RobotBuzzard/KegWasher/KegConfig.h

#define KEG_CONFIG_H
#include <Arduino.h>
#include <SPI.h>
#include <SD.h>
extern bool kwBenchMode;
#define airOk                  DI6
#define co2Ok                  DI7
#define ESTOP                  DI8
#define causticTemp            A10
#define waterOk                A11
#define causticLevelSensor     A12
#define largeKeg               IO0
#define cycleStart             IO1
#define manualDrain            IO2
#define co2Out                 IO3
#define alarmOut               IO4    // RED fault / E-stop stacklight (HIGH = on)
#define readyLedOut            IO5    // GREEN cycle-start / ready indicator (HIGH = on)
#define drainOut               CLEARCORE_PIN_CCIOA0
#define waterOut               CLEARCORE_PIN_CCIOA1
#define airOut                 CLEARCORE_PIN_CCIOA2
#define causticOut             CLEARCORE_PIN_CCIOA3
#define pumpOut                CLEARCORE_PIN_CCIOA4
#define sanitizerOut           CLEARCORE_PIN_CCIOA5
#define causticHeaterOut       CLEARCORE_PIN_CCIOA6
#define kegsDoneOut            CLEARCORE_PIN_CCIOA7  // HIGH while COMPLETE (swap-kegs
#define CcioPort               ConnectorCOM0
#define displayPort            ConnectorCOM1
#define settingsFileName       "WASHER.CFG"
#define KEY_MAX_LENGTH         30
#define VALUE_MAX_LENGTH       30
#define MACH_IDLE        0   // ready / not-ready; waiting for Start (see idleSub)
#define MACH_STARTING    1   // warm-up: heating caustic to temp before Execute
#define MACH_EXECUTE     2   // running the recipe (recipePhase advances within)
#define MACH_HELD        3   // paused mid-recipe; outputs safely held, timer frozen
#define MACH_COMPLETE    4   // cycle done; alarm; Start=next keg / Reset=park
#define MACH_STOPPING    5   // operator STOP/DRAIN: evacuating keg contents
#define MACH_STOPPED     6   // de-energized halt; Reset (Start) recovers
#define MACH_CLEARING    7   // fault acknowledged, verifying cleared → Stopped
#define MACH_ABORTED     8   // fault/ESTOP landing; alarm; Clear begins recovery
#define NUM_MACH_STATES  9
#define PHASE_NONE             0
#define PHASE_DIRTY_DRAIN      1   // air-push old product out (air + drain)   → drain
#define PHASE_DIRTY_RINSE      2   // pre-rinse water + drain                  → drain
#define PHASE_DIRTY_PURGE      3   // air-blow pre-rinse water + drain         → drain
#define PHASE_WASHING          4   // recirculate hot caustic (caustic + pump)
#define PHASE_CAUSTIC_RETURN   5   // air-blow caustic, drain+pump OFF         → caustic reservoir
#define PHASE_RINSING          6   // post-caustic rinse water + drain         → drain
#define PHASE_RINSE_PURGE      7   // air-blow rinse water + drain             → drain
#define PHASE_SANITIZE         8   // recirculate sanitizer (sanitizer + pump)
#define PHASE_SANI_RETURN      9   // CO2-blow sanitizer, drain+pump OFF       → sani reservoir
#define PHASE_PRESSURE         10  // CO2 charge, valves closed (seal keg)
#define NUM_PHASES             11
#define PHASE_FIRST            PHASE_DIRTY_DRAIN
#define PHASE_LAST             PHASE_PRESSURE
#define IDLE_INIT              0   // one-shot init ceremony on entering IDLE
#define IDLE_NOT_READY         1   // systems offline; shows which are failing
#define IDLE_READY             2   // ready; START begins a cycle
#define IDLE_SETTINGS          3   // on-screen settings editor (Phase 5 — not yet wired)
#define KW_FIRMWARE_VERSION    "1.0.2"
#define adcResolution          12
#define ADC_MAX                4095
#define DEF_ETS_SHUNT_OHMS     470.0f
extern float etsShuntOhms;
#define DEF_LARGE_KEG_MOD      1.5
#define DEFAULT_MIN_CAUSTIC_TEMP       50   // below this in WASHING → fault
#define DEFAULT_OPTIMAL_CAUSTIC_TEMP   60   // heater target during STARTING
#define DEFAULT_MAX_CAUSTIC_TEMP       70   // caustic safety cutoff
#define DEF_MIN_HEATING_RATE   3         // °C/min minimum during fw-mode heating
#define DEF_MAX_HEATING_MS     900000UL  // 15 min heating cap
extern int           minHeatingRate;     // SD key: minHeatingRate (°C/min)
extern unsigned long maxHeatingMs;       // SD key: maxHeatingMs (STARTING bound, both modes)
extern bool heaterExternal;
#define ERR_NONE              0
#define ERR_SD_INIT           1
#define ERR_CONFIG_FILE       2
#define ERR_WATER_PRESSURE    3
#define ERR_AIR_PRESSURE      4
#define ERR_CO2_PRESSURE      5
#define ERR_CAUSTIC_TEMP      6
#define ERR_ESTOP             8
#define ERR_INVALID_STATE     9
#define ERR_HEATING_TIMEOUT   10
#define ERR_HEATING_RATE      11
#define ERR_CAUSTIC_LEVEL     12
#define ERR_HEATER_OVERTEMP   13
#define ERR_STATE_TIMEOUT     14
#define ERR_SENSOR_FAULT      15
#define ERR_PAUSE_TIMEOUT     16
#define PAUSE_MAX_MS          (10UL * 60 * 1000)
extern unsigned long dirtyDrainTimer;   // DIRTY_DRAIN
extern unsigned long dirtyRinseTimer;   // DIRTY_RINSE
extern unsigned long dirtyPurgeTimer;   // DIRTY_PURGE
extern unsigned long washTimer;         // WASHING
extern unsigned long causticRtnTimer;   // CAUSTIC_RETURN (air-blow caustic → reservoir)
extern unsigned long rinseTimer;        // RINSING
extern unsigned long rinsePurgeTimer;   // RINSE_PURGE (air-blow rinse water → drain)
extern unsigned long saniTimer;         // SANITIZE
extern unsigned long saniRtnTimer;      // SANI_RETURN (CO2-blow sanitizer → reservoir)
extern unsigned long purgeTimer;        // PRESSURE (CO2 charge / seal)
extern unsigned long fullDrainTimer;
extern double largeKegMod;
extern unsigned long pauseMaxMs;
extern float  cfgTouchCal[6];    // touch calibration affine coeffs (a,b,c,d,e,f)
extern bool   cfgTouchCalValid;  // true once SD config supplied touchCalA..F
extern bool   cfgLoadedFromSD;   // true if WASHER.CFG was read; false = compiled defaults
extern int minCausticTemp;       // WASHING abort floor
extern int optimalCausticTemp;   // STARTING heater target
extern int tempCalOffsetC10;     // caustic probe calibration offset, tenths of a degree C (panel-tunable)
extern int maxCausticTemp;       // caustic safety cutoff
extern char mqttBrokerIp[16];    // dotted-quad string, e.g. "192.168.1.111"
extern int  mqttBrokerPort;
extern char mqttUser[32];
extern char mqttPass[32];
extern char mqttClientId[32];
extern char mqttTopicRoot[32];
extern char webUser[24];
extern char webPass[24];
extern bool netStaticMode;
extern char netIp[16];
extern char netMask[16];
extern char netGw[16];
bool config_parseIp(const char* s, uint8_t out[4]);
extern bool kwCfgMirrorDirty;
void config_init();
bool config_loadFromSD();
void config_saveToSD();
void config_setDefaults();
#define KW_CFG_APPLIED   0
#define KW_CFG_UNKNOWN   1
#define KW_CFG_REJECTED  2
byte config_applyKV(const char* key, const char* value);
bool config_tempsOrdered();   // floor ≤ target < cutoff
