RobotBuzzard/KegWasher/KegConfig.cpp

// ======================================================================
// KegConfig.cpp - SD config load/save with bounded validation
// ======================================================================
#include "KegConfig.h"
#include "KegUtils.h"
#include "KegDisplay.h"
#include "KegDiagnostics.h"
#include "KegSecrets.h"   // compiled MQTT broker/cred defaults (seed the runtime globals)

// Stringize the 4 broker-IP octet macros into a "a.b.c.d" literal for the
// compile-time default of mqttBrokerIp (static init can't run snprintf).
#define KW_STR2(x) #x
#define KW_STR(x)  KW_STR2(x)

// Per-stage default durations (ms). The washer is a TWO-HEAD system — one cycle
// cleans 2 kegs in parallel — so these are per-cycle (both kegs), not per keg.
// Production defaults total ≈ 4.4 min/cycle; tune per process via WASHER.CFG or
// the on-screen settings editor. BENCH_MODE compresses every stage to 5 s so a
// cardless bench cycle runs in ~50 s. (5 s multiples → clean ±5 s editor steps.)
  #define DEF_DIRTY_DRAIN_MS  20000UL   // drain old beer (air on whole stage)
  #define DEF_DIRTY_RINSE_MS  20000UL   // pre-rinse
  #define DEF_DIRTY_PURGE_MS  10000UL   // air blow to drain
  #define DEF_WASH_MS         90000UL   // caustic recirc — the real clean
  #define DEF_CAUSTIC_RTN_MS  15000UL   // air-blow caustic back to tank
  #define DEF_RINSE_MS        25000UL   // post-caustic rinse
  #define DEF_RINSE_PURGE_MS  10000UL   // air blow to drain
  #define DEF_SANI_MS         45000UL   // sanitizer recirc
  #define DEF_SANI_RTN_MS     15000UL   // CO2-blow sani back to tank
  #define DEF_PRESSURE_MS     15000UL   // CO2 charge / seal
  #define DEF_FULL_DRAIN_MS   180000UL  // DIRTY_DRAIN w/ DRAIN switch latched (full kegs)

// Stage durations, in cycle order. See KegConfig.h for the stage each drives.
unsigned long dirtyDrainTimer = DEF_DIRTY_DRAIN_MS;
unsigned long dirtyRinseTimer = DEF_DIRTY_RINSE_MS;
unsigned long dirtyPurgeTimer = DEF_DIRTY_PURGE_MS;
unsigned long washTimer       = DEF_WASH_MS;
unsigned long causticRtnTimer = DEF_CAUSTIC_RTN_MS;
unsigned long rinseTimer      = DEF_RINSE_MS;
unsigned long rinsePurgeTimer = DEF_RINSE_PURGE_MS;
unsigned long saniTimer       = DEF_SANI_MS;
unsigned long saniRtnTimer    = DEF_SANI_RTN_MS;
unsigned long purgeTimer      = DEF_PRESSURE_MS;
unsigned long fullDrainTimer  = DEF_FULL_DRAIN_MS;
double        largeKegMod     = DEF_LARGE_KEG_MOD;
unsigned long pauseMaxMs      = PAUSE_MAX_MS;   // runtime; SD-overridable (Phase 3)

// Temperature thresholds (°C) — seeded from DEFAULT_*; SD-overridable.
int minCausticTemp     = DEFAULT_MIN_CAUSTIC_TEMP;
int optimalCausticTemp = DEFAULT_OPTIMAL_CAUSTIC_TEMP;
int maxCausticTemp     = DEFAULT_MAX_CAUSTIC_TEMP;
int tempCalOffsetC10   = 0;   // calibration trim vs a reference thermometer

// Heating bounds + temp-sensor shunt — SD-overridable (were compile-time).
int           minHeatingRate = DEF_MIN_HEATING_RATE;
unsigned long maxHeatingMs   = DEF_MAX_HEATING_MS;
float         etsShuntOhms   = DEF_ETS_SHUNT_OHMS;

// Heater control mode — see KegConfig.h. Default fw (safe on direct wiring).
bool heaterExternal = false;

// Runtime bench mode — set in config_init(): no SD config -> bench (gates
// bypassed + 5 s stages); card present -> production gates, unless the card
// (or a remote edit) says benchMode=on. See KegConfig.h.
bool kwBenchMode = false;
// benchMode SD key state: seen-in-file + its value. Needed because the loader
// runs BEFORE config_init() decides the card-present default — config_init
// consults these instead of the (would-be-clobbered) kwBenchMode itself.
static bool cfgBenchKeySeen = false;
static bool cfgBenchKeyVal  = false;

// Network config — applied at BOOT by setupEthernet(); a remote edit needs a
// power cycle to take effect. netMode=static requires a valid netIp (else the
// boot logs a fallback and uses DHCP). netMask defaults to 255.255.255.0 and
// netGw to .1 on the IP's subnet when unset.
bool netStaticMode = false;
char netIp[16]   = "";
char netMask[16] = "";
char netGw[16]   = "";

// Dotted-quad parser shared by validation and setupEthernet.
bool config_parseIp(const char* s, uint8_t out[4]) {
  int v[4];
  char extra;
  if (sscanf(s, "%d.%d.%d.%d%c", &v[0], &v[1], &v[2], &v[3], &extra) != 4) {
    return false;
  }
  for (int i = 0; i < 4; i++) {
    if (v[i] < 0 || v[i] > 255) return false;
    out[i] = (uint8_t)v[i];
  }
  return true;
}

// Web editor HTTP Basic auth — both must be non-empty to arm it. Never
// published to the cfg/* mirror or cfg.json; settable remotely (masked in
// acks/logs) so the lock can be enabled from the editor itself. Recovery
// from a lost password: pull the card and edit/delete the webUser/webPass
// lines in WASHER.CFG.
char webUser[24] = "";
char webPass[24] = "";

// MQTT broker config — seeded from KegSecrets.h; SD-overridable per device.
char mqttBrokerIp[16]  = KW_STR(MQTT_BROKER_IP_0) "." KW_STR(MQTT_BROKER_IP_1) "."
                         KW_STR(MQTT_BROKER_IP_2) "." KW_STR(MQTT_BROKER_IP_3);
int  mqttBrokerPort    = MQTT_BROKER_PORT;
char mqttUser[32]      = MQTT_USER;
char mqttPass[32]      = MQTT_PASS;
char mqttClientId[32]  = MQTT_CLIENT_ID;
char mqttTopicRoot[32] = MQTT_TOPIC_ROOT;

// Touch calibration (host-side affine: screen=[a b c; d e f].[rawx rawy 1]).
// KegDisplaySerial has its own baked defaults; these only override when the SD
// config supplies touchCalA..F (which sets cfgTouchCalValid → display_init applies).
float cfgTouchCal[6]  = {1, 0, 0, 0, 1, 0};
bool  cfgTouchCalValid = false;
bool  cfgLoadedFromSD  = false;   // set by config_init(); drives the boot-screen SD line

// Set by every config_saveToSD(); the main loop republishes the MQTT cfg/*
// mirror and clears it. Closes the two-editor desync: the PANEL settings
// editor saves without touching MQTT, which left the mirror (and anything
// watching it) showing stale values — bitten 2026-07-05 when MIN TEMP was
// changed on-panel while the mirror still said the web-set value.
bool kwCfgMirrorDirty = false;

static File settingsFile;

// Accept timer values from 5s to 30min. The 5s floor allows the genuinely short
// purge/return/charge stages (air blow-down, CO2 charge) while still rejecting
// obvious typos (e.g. a forgotten trailing zero / a 0-length stage).
static const unsigned long TIMER_MIN_MS = 5000UL;
static const unsigned long TIMER_MAX_MS = 1800000UL;
static const double KEGMOD_MIN = 1.0;
static const double KEGMOD_MAX = 3.0;
static const int  TEMP_MIN_C   = 0;        // plausible threshold range (°C)
static const int  TEMP_MAX_C   = 120;
static const unsigned long PAUSE_MIN_MS   = 60000UL;       // 1 min
static const unsigned long PAUSE_LIMIT_MS = 3600000UL;     // 60 min

static void logOutOfRange(const char* key, const char* value) {
  diagnostics_logEvent((String("Config out of range: ") + key + "=" + value).c_str());
}

static bool applyTimerKey(const char* key, const char* value, unsigned long& target) {
  unsigned long v = strtoul(value, nullptr, 10);
  if (v < TIMER_MIN_MS || v > TIMER_MAX_MS) { logOutOfRange(key, value); return false; }
  target = v;
  return true;
}

// Bounded integer (temperature thresholds).
static bool applyTempKey(const char* key, const char* value, int& target) {
  int v = atoi(value);
  if (v < TEMP_MIN_C || v > TEMP_MAX_C) { logOutOfRange(key, value); return false; }
  target = v;
  return true;
}

// Free-form string value → fixed buffer (snprintf null-terminates + truncates).
static void applyStrKey(const char* value, char* target, size_t cap) {
  snprintf(target, cap, "%s", value);
}

// Apply one KEY=VALUE pair with bounded validation — the single rulebook shared
// by the SD loader and the remote (MQTT cfgset) editor. Returns:
//   KW_CFG_APPLIED   value accepted (target updated)
//   KW_CFG_UNKNOWN   key not recognised (loader ignores; remote editor errors)
//   KW_CFG_REJECTED  value out of range (logged; target unchanged)
byte config_applyKV(const char* key, const char* value) {
  if      (strcmp(key, "fullDrainTimer") == 0)  return applyTimerKey(key, value, fullDrainTimer)  ? KW_CFG_APPLIED : KW_CFG_REJECTED;
  else if (strcmp(key, "dirtyDrainTimer") == 0) return applyTimerKey(key, value, dirtyDrainTimer) ? KW_CFG_APPLIED : KW_CFG_REJECTED;
  else if (strcmp(key, "dirtyRinseTimer") == 0) return applyTimerKey(key, value, dirtyRinseTimer) ? KW_CFG_APPLIED : KW_CFG_REJECTED;
  else if (strcmp(key, "dirtyPurgeTimer") == 0) return applyTimerKey(key, value, dirtyPurgeTimer) ? KW_CFG_APPLIED : KW_CFG_REJECTED;
  else if (strcmp(key, "washTimer")       == 0) return applyTimerKey(key, value, washTimer)       ? KW_CFG_APPLIED : KW_CFG_REJECTED;
  else if (strcmp(key, "causticRtnTimer") == 0) return applyTimerKey(key, value, causticRtnTimer) ? KW_CFG_APPLIED : KW_CFG_REJECTED;
  else if (strcmp(key, "rinseTimer")      == 0) return applyTimerKey(key, value, rinseTimer)      ? KW_CFG_APPLIED : KW_CFG_REJECTED;
  else if (strcmp(key, "rinsePurgeTimer") == 0) return applyTimerKey(key, value, rinsePurgeTimer) ? KW_CFG_APPLIED : KW_CFG_REJECTED;
  else if (strcmp(key, "saniTimer")       == 0) return applyTimerKey(key, value, saniTimer)       ? KW_CFG_APPLIED : KW_CFG_REJECTED;
  else if (strcmp(key, "saniRtnTimer")    == 0) return applyTimerKey(key, value, saniRtnTimer)    ? KW_CFG_APPLIED : KW_CFG_REJECTED;
  else if (strcmp(key, "purgeTimer")      == 0) return applyTimerKey(key, value, purgeTimer)      ? KW_CFG_APPLIED : KW_CFG_REJECTED;
  else if (strcmp(key, "largeKegMod")     == 0) {
    double v = atof(value);
    if (v < KEGMOD_MIN || v > KEGMOD_MAX) { logOutOfRange(key, value); return KW_CFG_REJECTED; }
    largeKegMod = v;
    return KW_CFG_APPLIED;
  }
  else if (strcmp(key, "pauseMaxMs")      == 0) {
    unsigned long v = strtoul(value, nullptr, 10);
    if (v < PAUSE_MIN_MS || v > PAUSE_LIMIT_MS) { logOutOfRange(key, value); return KW_CFG_REJECTED; }
    pauseMaxMs = v;
    return KW_CFG_APPLIED;
  }
  // Temperature thresholds (°C)
  else if (strcmp(key, "minCausticTemp")     == 0) return applyTempKey(key, value, minCausticTemp)     ? KW_CFG_APPLIED : KW_CFG_REJECTED;
  else if (strcmp(key, "optimalCausticTemp") == 0) return applyTempKey(key, value, optimalCausticTemp) ? KW_CFG_APPLIED : KW_CFG_REJECTED;
  else if (strcmp(key, "maxCausticTemp")     == 0) return applyTempKey(key, value, maxCausticTemp)     ? KW_CFG_APPLIED : KW_CFG_REJECTED;
  else if (strcmp(key, "tempCalOffsetC10") == 0) {
    int v = atoi(value);
    if (v < -100 || v > 100) { logOutOfRange(key, value); return KW_CFG_REJECTED; }   // +/-10.0 C max trim
    tempCalOffsetC10 = v;
    return KW_CFG_APPLIED;
  }
  else if (strcmp(key, "heaterMode")      == 0) {
    if      (strcmp(value, "ext") == 0) heaterExternal = true;
    else if (strcmp(value, "fw")  == 0) heaterExternal = false;
    else { logOutOfRange(key, value); return KW_CFG_REJECTED; }
    return KW_CFG_APPLIED;
  }
  else if (strcmp(key, "maxHeatingMs")    == 0) {
    unsigned long v = strtoul(value, nullptr, 10);
    if (v < 60000UL || v > 7200000UL) { logOutOfRange(key, value); return KW_CFG_REJECTED; }   // 1 min..2 h
    maxHeatingMs = v;
    return KW_CFG_APPLIED;
  }
  else if (strcmp(key, "minHeatingRate")  == 0) {
    int v = atoi(value);
    if (v < 1 || v > 50) { logOutOfRange(key, value); return KW_CFG_REJECTED; }                // °C/min
    minHeatingRate = v;
    return KW_CFG_APPLIED;
  }
  else if (strcmp(key, "etsShuntOhms")    == 0) {
    double v = atof(value);
    if (v < 100.0 || v > 1000.0) { logOutOfRange(key, value); return KW_CFG_REJECTED; }
    etsShuntOhms = (float)v;
    return KW_CFG_APPLIED;
  }
  else if (strcmp(key, "webUser")         == 0) { applyStrKey(value, webUser, sizeof(webUser)); return KW_CFG_APPLIED; }
  else if (strcmp(key, "webPass")         == 0) { applyStrKey(value, webPass, sizeof(webPass)); return KW_CFG_APPLIED; }
  else if (strcmp(key, "netMode")         == 0) {
    if      (strcmp(value, "static") == 0) netStaticMode = true;
    else if (strcmp(value, "dhcp")   == 0) netStaticMode = false;
    else { logOutOfRange(key, value); return KW_CFG_REJECTED; }
    return KW_CFG_APPLIED;
  }
  else if (strcmp(key, "netIp") == 0 || strcmp(key, "netMask") == 0 ||
           strcmp(key, "netGw") == 0) {
    // Empty clears (back to the documented default); non-empty must parse.
    uint8_t d[4];
    if (value[0] && !config_parseIp(value, d)) { logOutOfRange(key, value); return KW_CFG_REJECTED; }
    char* dst = (key[3] == 'I') ? netIp : (key[3] == 'M') ? netMask : netGw;
    applyStrKey(value, dst, 16);
    return KW_CFG_APPLIED;
  }
  else if (strcmp(key, "benchMode")       == 0) {
    // Bench with a card: gates bypassed, but the card's timers/thresholds are
    // used (the 5 s compression is cardless-only). Applies immediately on a
    // remote set; at boot config_init() finalizes from cfgBenchKey*.
    if      (strcmp(value, "on")  == 0) cfgBenchKeyVal = true;
    else if (strcmp(value, "off") == 0) cfgBenchKeyVal = false;
    else { logOutOfRange(key, value); return KW_CFG_REJECTED; }
    cfgBenchKeySeen = true;
    kwBenchMode = cfgBenchKeyVal;
    return KW_CFG_APPLIED;
  }
  // (maxEnclosureTemp/fanOnTemp/fanOffTemp keys retired — enclosure temp/fan
  //  are off-controller now; such keys in an old WASHER.CFG are silently ignored.)
  // MQTT broker config (override the KegSecrets.h compiled defaults)
  else if (strcmp(key, "mqttBrokerIp")    == 0) { applyStrKey(value, mqttBrokerIp,  sizeof(mqttBrokerIp));  return KW_CFG_APPLIED; }
  else if (strcmp(key, "mqttBrokerPort")  == 0) {
    long p = strtol(value, nullptr, 10);
    if (p < 1 || p > 65535) { logOutOfRange(key, value); return KW_CFG_REJECTED; }
    mqttBrokerPort = (int)p;
    return KW_CFG_APPLIED;
  }
  else if (strcmp(key, "mqttUser")        == 0) { applyStrKey(value, mqttUser,      sizeof(mqttUser));      return KW_CFG_APPLIED; }
  else if (strcmp(key, "mqttPass")        == 0) { applyStrKey(value, mqttPass,      sizeof(mqttPass));      return KW_CFG_APPLIED; }
  else if (strcmp(key, "mqttClientId")    == 0) { applyStrKey(value, mqttClientId,  sizeof(mqttClientId));  return KW_CFG_APPLIED; }
  else if (strcmp(key, "mqttTopicRoot")   == 0) { applyStrKey(value, mqttTopicRoot, sizeof(mqttTopicRoot)); return KW_CFG_APPLIED; }
  else if (strncmp(key, "touchCal", 8) == 0 && key[8] >= 'A' && key[8] <= 'F' && key[9] == '\0') {
    cfgTouchCal[key[8] - 'A'] = atof(value);   // touchCalA..F -> affine coeffs
    cfgTouchCalValid = true;
    return KW_CFG_APPLIED;
  }
  return KW_CFG_UNKNOWN;   // loader ignores (forward-compat); remote editor errors
}

// The three temps must be ordered (floor ≤ target < cutoff) to be coherent.
bool config_tempsOrdered() {
  return minCausticTemp <= optimalCausticTemp && optimalCausticTemp < maxCausticTemp;
}

void config_init() {
  analogReadResolution(adcResolution);

  if (config_loadFromSD()) {
    cfgLoadedFromSD = true;
    // Card present -> production gates, unless the card explicitly says
    // benchMode=on (bench work with real timers/thresholds loaded).
    kwBenchMode = cfgBenchKeySeen ? cfgBenchKeyVal : false;
  } else {
    cfgLoadedFromSD = false;
    config_setDefaults();
    // No card -> BENCH MODE: sensor gates bypassed and every stage
    // compressed to 5 s so a cardless bench cycle runs in ~50 s.
    kwBenchMode = true;
    dirtyDrainTimer = dirtyRinseTimer = dirtyPurgeTimer = washTimer =
      causticRtnTimer = rinseTimer = rinsePurgeTimer = saniTimer =
      saniRtnTimer = purgeTimer = 5000UL;
    fullDrainTimer = 10000UL;   // bench: distinguishable from the 5 s stages
  }
}

bool config_loadFromSD() {
  if (!SD.begin()) {
    diagnostics_logEvent("SD init failed");
    display_showError("SD card init failed");
    delay(1500);
    return false;
  }

  settingsFile = SD.open(settingsFileName, FILE_READ);
  if (!settingsFile) {
    diagnostics_logEvent("Config file not found");
    display_showError("Config file missing");
    delay(1500);
    return false;
  }

  char key[KEY_MAX_LENGTH] = {0};
  char value[VALUE_MAX_LENGTH] = {0};
  char line[KEY_MAX_LENGTH + VALUE_MAX_LENGTH + 2] = {0};

  while (settingsFile.available()) {
    size_t i = 0;
    while (settingsFile.available() && i < sizeof(line) - 1) {
      char c = settingsFile.read();
      if (c == '\n') break;
      line[i++] = c;
    }
    line[i] = '\0';

    if (!utils_parseConfigLine(line, key, value)) continue;
    // Shared rulebook (config_applyKV): out-of-range values are logged and
    // kept at their prior/default value; unknown keys are silently ignored —
    // forward-compat with newer config files.
    config_applyKV(key, value);
  }

  settingsFile.close();

  // Cross-field sanity: the three temps must be ordered (floor ≤ target < cutoff).
  // Each key is individually range-checked above, but an unordered trio (e.g.
  // minCausticTemp=80 with maxCausticTemp=70) is self-contradictory — revert
  // ALL THREE to the compiled defaults; a half-applied trio is worse than none.
  if (!config_tempsOrdered()) {
    diagnostics_logEvent("Config temps out of order - defaults used");
    minCausticTemp     = DEFAULT_MIN_CAUSTIC_TEMP;
    optimalCausticTemp = DEFAULT_OPTIMAL_CAUSTIC_TEMP;
    maxCausticTemp     = DEFAULT_MAX_CAUSTIC_TEMP;
  }
  return true;
}

void config_saveToSD() {
  if (SD.exists(settingsFileName)) SD.remove(settingsFileName);

  settingsFile = SD.open(settingsFileName, FILE_WRITE);
  if (!settingsFile) {
    display_showError("Cannot create config");
    delay(1500);
    return;
  }

  settingsFile.print("dirtyDrainTimer="); settingsFile.println(dirtyDrainTimer);
  settingsFile.print("dirtyRinseTimer="); settingsFile.println(dirtyRinseTimer);
  settingsFile.print("dirtyPurgeTimer="); settingsFile.println(dirtyPurgeTimer);
  settingsFile.print("washTimer=");       settingsFile.println(washTimer);
  settingsFile.print("causticRtnTimer="); settingsFile.println(causticRtnTimer);
  settingsFile.print("rinseTimer=");      settingsFile.println(rinseTimer);
  settingsFile.print("rinsePurgeTimer="); settingsFile.println(rinsePurgeTimer);
  settingsFile.print("saniTimer=");       settingsFile.println(saniTimer);
  settingsFile.print("saniRtnTimer=");    settingsFile.println(saniRtnTimer);
  settingsFile.print("purgeTimer=");      settingsFile.println(purgeTimer);
  settingsFile.print("fullDrainTimer=");  settingsFile.println(fullDrainTimer);
  settingsFile.print("largeKegMod=");     settingsFile.println(largeKegMod);
  settingsFile.print("pauseMaxMs=");      settingsFile.println(pauseMaxMs);

  // Temperature thresholds
  settingsFile.print("minCausticTemp=");     settingsFile.println(minCausticTemp);
  settingsFile.print("optimalCausticTemp="); settingsFile.println(optimalCausticTemp);
  settingsFile.print("maxCausticTemp=");     settingsFile.println(maxCausticTemp);
  settingsFile.print("tempCalOffsetC10=");   settingsFile.println(tempCalOffsetC10);
  // heaterMode is SD-only but MUST survive a panel save (this writer does a
  // full rewrite — omitting the key would silently flip a unit back to fw).
  settingsFile.print("heaterMode=");         settingsFile.println(heaterExternal ? "ext" : "fw");

  // SD-only keys — same full-rewrite survival requirement as heaterMode.
  settingsFile.print("benchMode=");          settingsFile.println(kwBenchMode ? "on" : "off");
  settingsFile.print("maxHeatingMs=");       settingsFile.println(maxHeatingMs);
  settingsFile.print("minHeatingRate=");     settingsFile.println(minHeatingRate);
  settingsFile.print("etsShuntOhms=");       settingsFile.println(etsShuntOhms, 1);
  // Network: mode always; addresses only when set (empty = documented default).
  settingsFile.print("netMode=");            settingsFile.println(netStaticMode ? "static" : "dhcp");
  if (netIp[0])   { settingsFile.print("netIp=");   settingsFile.println(netIp);   }
  if (netMask[0]) { settingsFile.print("netMask="); settingsFile.println(netMask); }
  if (netGw[0])   { settingsFile.print("netGw=");   settingsFile.println(netGw);   }
  // Web-editor auth: written only when armed (both set), so an unused lock
  // doesn't leave empty keys in the file. Survives the full rewrite like
  // heaterMode — dropping them would silently unlock the editor.
  if (webUser[0] && webPass[0]) {
    settingsFile.print("webUser=");          settingsFile.println(webUser);
    settingsFile.print("webPass=");          settingsFile.println(webPass);
  }
  // Touch calibration: only present when the SD supplied it (cfgTouchCalValid);
  // dropping it here would silently revert touch to the baked-in cal on reboot.
  if (cfgTouchCalValid) {
    for (int i = 0; i < 6; i++) {
      settingsFile.print("touchCal"); settingsFile.print((char)('A' + i));
      settingsFile.print("=");        settingsFile.println(cfgTouchCal[i], 6);
    }
  }

  kwCfgMirrorDirty = true;   // main loop republishes the cfg/* mirror

  // NOTE: the MQTT broker block is intentionally NOT written here. This save does
  // SD.remove + full rewrite, so it INTENTIONALLY drops any MQTT block from the
  // file — the device then falls back to compiled KegSecrets.h creds on next boot.
  // Rationale: the on-device editor only tunes timers/thresholds; previously it
  // rewrote MQTT from RAM, which let a save clobber the broker creds with stale/
  // placeholder values (and wrote the password to the card on every timer edit).
  // Consequence: don't rely on SD-only MQTT creds AND the on-device editor on the
  // same unit — provision MQTT via KegSecrets.h (or the future host configurator)
  // if operators will edit timers on the panel.
  settingsFile.close();
}

void config_setDefaults() {
  dirtyDrainTimer = DEF_DIRTY_DRAIN_MS;
  dirtyRinseTimer = DEF_DIRTY_RINSE_MS;
  dirtyPurgeTimer = DEF_DIRTY_PURGE_MS;
  washTimer       = DEF_WASH_MS;
  causticRtnTimer = DEF_CAUSTIC_RTN_MS;
  rinseTimer      = DEF_RINSE_MS;
  rinsePurgeTimer = DEF_RINSE_PURGE_MS;
  saniTimer       = DEF_SANI_MS;
  saniRtnTimer    = DEF_SANI_RTN_MS;
  purgeTimer      = DEF_PRESSURE_MS;
  fullDrainTimer  = DEF_FULL_DRAIN_MS;
  largeKegMod     = DEF_LARGE_KEG_MOD;
  pauseMaxMs      = PAUSE_MAX_MS;

  minCausticTemp     = DEFAULT_MIN_CAUSTIC_TEMP;
  optimalCausticTemp = DEFAULT_OPTIMAL_CAUSTIC_TEMP;
  maxCausticTemp     = DEFAULT_MAX_CAUSTIC_TEMP;
  tempCalOffsetC10   = 0;
  heaterExternal     = false;
  minHeatingRate     = DEF_MIN_HEATING_RATE;
  maxHeatingMs       = DEF_MAX_HEATING_MS;
  etsShuntOhms       = DEF_ETS_SHUNT_OHMS;
  webUser[0]         = '\0';
  webPass[0]         = '\0';
  netStaticMode      = false;
  netIp[0]           = '\0';
  netMask[0]         = '\0';
  netGw[0]           = '\0';

  snprintf(mqttBrokerIp, sizeof(mqttBrokerIp), "%d.%d.%d.%d",
           MQTT_BROKER_IP_0, MQTT_BROKER_IP_1, MQTT_BROKER_IP_2, MQTT_BROKER_IP_3);
  mqttBrokerPort = MQTT_BROKER_PORT;
  snprintf(mqttUser,      sizeof(mqttUser),      "%s", MQTT_USER);
  snprintf(mqttPass,      sizeof(mqttPass),      "%s", MQTT_PASS);
  snprintf(mqttClientId,  sizeof(mqttClientId),  "%s", MQTT_CLIENT_ID);
  snprintf(mqttTopicRoot, sizeof(mqttTopicRoot), "%s", MQTT_TOPIC_ROOT);
}
