RobotBuzzard/KegWasher/KegDisplaySerial.cpp

// ======================================================================
// KegDisplaySerial.cpp — raw SPE serial UI for the gen4-uLCD-43DT (Diablo16).
// See KegDisplaySerial.h. Write-only commands + RX drain → desync-free.
//
// Visual language ("direction C", 2026-06-10): minimal typographic on black.
// State is a 6 px edge strip + semantic accents only; DejaVu proportional
// fonts (FONT_7/FONT_8 bold) positioned pixel-exact via gfx_MoveTo (all
// verified on hardware by tools/diablo_capability_probe). Layout grid:
// content x=18..258, thin TRACK rules between sections, footer bar at 462.
// ======================================================================
#include "KegDisplaySerial.h"
#include <ClearCore.h>
#include "Diablo_Serial_4DLib.h"
#include "Diablo_Const4D.h"

namespace {
  const int DW = 272, DH = 480;   // PORTRAIT — panel mounted 272W x 480H

  // ---- palette (RGB565, quantized from the approved mockups) ----
  const word C_BG      = 0x0000;  // black
  const word C_TXT     = 0xEF7E;  // #ECEFF1 near-white
  const word C_SUB     = 0x84B4;  // #8494A0 secondary text
  const word C_TRACK   = 0x29A8;  // #2D3740 rules / inactive
  const word C_CARD    = 0x1904;  // #1C2226 footer bar / fields
  const word C_CARDHI  = 0x2166;  // #262E36 secondary button fill
  const word C_GRN     = 0x064A;  // #00C853 running / ok
  const word C_GRN_TXT = 0x0102;  // dark green text on green fill
  const word C_AMB     = 0xFD80;  // #FFB300 held / warning
  const word C_AMB_TXT = 0x18A0;  // dark amber text on amber fill
  const word C_RED     = 0xE1C6;  // #E53935 fault
  const word C_CYAN    = 0x05FA;  // #00BCD4 info accent / links
  const word C_BLUE    = 0x1C5C;  // #1E88E5 operator action / transition
  const word C_DIMGRN  = 0x0346;  // #006934 idle-connected dot

  // legacy callers pass saturated GREEN/AMBER/RED/BLUE literals — remap to
  // the design palette so KegDisplay didn't have to change its constants.
  word remap(word c) {
    switch (c) {
      case 0x07E0: return C_GRN;   case 0xFD20: return C_AMB;
      case 0xF800: return C_RED;   case 0x001F: return C_BLUE;
      case 0x0010: return C_BLUE;  case 0xFFE0: return C_AMB;
      case 0x07FF: return C_CYAN;  default:     return c;
    }
  }
  // label ink per fill — explicit, not luma-guessed (green/amber/cyan/white
  // fills read better with dark ink; red/blue/dark fills with near-white)
  word inkOn(word fill) {
    if (fill == C_AMB)  return C_AMB_TXT;
    if (fill == C_GRN)  return C_GRN_TXT;
    if (fill == C_CYAN) return C_GRN_TXT;
    if (fill == 0xFFFF) return 0x0000;
    return C_TXT;
  }

  // ---- layout grid ----
  const int LX = 18, RX = DW - 14;          // content left / right edge
  const int STRIP_W   = 6;
  const int TITLE_Y   = 8;
  const int META_Y    = 50;
  const int RULE1_Y   = 84;
  const int BANNER_Y1 = 90, BANNER_Y2 = 126;
  const int FOOT_Y    = DH - 18;

  // operating screen fields
  const int TMR_Y = 134, TMR_CLR_Y2 = 204;
  const int REM_Y = 210;
  const int RULE2_Y = 244;
  const int TMP_Y = 254, TMP_CLR_Y2 = 284;
  const int TMPSUB_Y = 286;
  const int RULE3_Y = 320;
  const int SENS_Y = 330;                   // 2x2 grid, rows +34 (readiness screens)

  // Operating-screen OUT/IN telemetry grid (replaces the 2x2 sensor grid while
  // running): all 8 actuator outputs over two 4-col rows + all 5 inputs on one
  // 5-col row, between RULE3 (320) and the PAUSE button (400). Scale-1 labels.
  const int IO_R1_Y = 326, IO_ROW_H = 24;   // rows at 326 / 350 / 374
  const int IO_X0   = LX + 34;              // cells start right of the OUT/IN tags
  const int IO_OUT_PITCH = 46;              // 4 columns
  const int IO_IN_PITCH  = 41;              // 5 columns
  const int FOOT_DOT_WEB_X = 220;   // web-editor activity (green when browsing)
  const int FOOT_DOT_PUB_X = 238, FOOT_DOT_SUB_X = 256, FOOT_DOT_Y = DH - 9;

  Diablo_Serial_4DLib* D = nullptr;
  volatile uint32_t g_err = 0;
  void onTO(int, unsigned char) { g_err++; }

  inline void drain() { while (Serial1.available()) Serial1.read(); }
  void bg(word c)                              { drain(); D->gfx_Set(BACKGROUND_COLOUR, c); }
  // forward decl — cls() must invalidate the text-state cache (defined below)
  void textStateReset();
  void cls() {
    drain(); D->gfx_Cls();
    // gfx_Cls resets the panel's text parameters (opacity back to OPAQUE,
    // background to black) — camera-diagnosed 2026-06-10 as the black-box /
    // "underline" artifact behind labels on coloured fills. Re-assert
    // transparency and drop the host-side cache so attrs get re-issued.
    drain(); D->txt_Set(TEXT_OPACITY, 0);
    textStateReset();
  }
  void rect(int a,int b,int c,int d,word col)  { drain(); D->gfx_RectangleFilled(a,b,c,d,col); }
  void hline(int x1,int x2,int y,word col)     { drain(); D->gfx_Line(x1,y,x2,y,col); }
  void disc(int x,int y,int r,word col)        { drain(); D->gfx_CircleFilled(x,y,r,col); }

  // rounded rect = 2 rects + 4 discs (no gfx_RoundPanel over SPE)
  void rrect(int x1,int y1,int x2,int y2,int r,word col) {
    rect(x1 + r, y1, x2 - r, y2, col);
    rect(x1, y1 + r, x2, y2 - r, col);
    disc(x1 + r, y1 + r, r, col); disc(x2 - r, y1 + r, r, col);
    disc(x1 + r, y2 - r, r, col); disc(x2 - r, y2 - r, r, col);
  }

  // ---- text engine: DejaVu fonts, pixel-positioned, width-measured ----
  // FONT_7 = DejaVu Sans 9pt, FONT_8 = DejaVu Sans Bold 9pt (probe-verified).
  // Glyph widths are queried once at begin() (charwidth is per current font)
  // so labels can be centred / right-aligned without GetAckResp at draw time.
  byte g_w7[95], g_w8[95];                  // widths for ASCII 32..126
  int  g_h7 = 13, g_h8 = 13;                // cell heights (queried at begin)
  // Visual metrics of CAPS within the FONT_8 cell, measured at begin() by
  // rendering an 'E' and reading it back (gfx_GetPixel) — the engine's own
  // truth, replacing camera-calibrated fudge constants.
  int  g_capTop8 = 0, g_capH8 = 13;

  // current text state — cached to skip redundant txt_Set spam
  word g_font = 0xFFFF, g_fg = 0xFFFF, g_bgc = 0xFFFF;
  int  g_sx = -1, g_sy = -1, g_gap = -1;
  void textStateReset() { g_font = 0xFFFF; g_fg = g_bgc = 0xFFFF; g_sx = g_sy = -1; g_gap = -1; }

  void setGap(int gap) {
    if (gap != g_gap) { drain(); D->txt_Set(TEXT_XGAP, gap); g_gap = gap; }
  }
  void setFontRaw(word f, int sx, int sy, word fg) {
    if (f != g_font)  { drain(); D->txt_FontID(f);            g_font = f; }
    if (sx != g_sx)   { drain(); D->txt_Set(TEXT_WIDTH,  sx); g_sx = sx; }
    if (sy != g_sy)   { drain(); D->txt_Set(TEXT_HEIGHT, sy); g_sy = sy; }
    if (fg != g_fg)   { drain(); D->txt_Set(TEXT_COLOUR, fg); g_fg = fg; }
  }
  void setFont(bool bold, int sx, int sy, word fg, word bgc) {
    word f = bold ? FONT_8 : FONT_7;
    if (f != g_font)  { drain(); D->txt_FontID(f);            g_font = f; }
    if (sx != g_sx)   { drain(); D->txt_Set(TEXT_WIDTH,  sx); g_sx = sx; }
    if (sy != g_sy)   { drain(); D->txt_Set(TEXT_HEIGHT, sy); g_sy = sy; }
    if (fg != g_fg)   { drain(); D->txt_Set(TEXT_COLOUR, fg); g_fg = fg; }
    (void)bgc;   // transparent text — background colour unused
  }

  int strW(const char* s, bool bold, int sx) {
    const byte* t = bold ? g_w8 : g_w7;
    long w = 0;
    for (; *s; s++) {
      unsigned ch = (unsigned char)*s;
      if (ch >= 32 && ch <= 126) w += t[ch - 32];
      else w += t['o' - 32];                // non-ASCII (°): assume ~'o' wide
    }
    return (int)(w * sx);
  }

  void put(const char* s) { while (*s) { drain(); D->putCH((word)(uint8_t)*s++); } }

  void textAt(int x, int y, const char* s) {
    drain(); D->gfx_MoveTo(x, y);
    put(s);
  }
  void lbl(int x, int y, bool bold, int sx, int sy, word fg, word bgc, const char* s) {
    // Vertically-stretched regular text reads as skinny strokes (height
    // scales, stroke width doesn't) — compensate with the bold face.
    if (sy > sx) bold = true;
    setFont(bold, sx, sy, fg, bgc);
    textAt(x, y, s);
  }
  // Subtitle face: FONT_4 (12x16 system) — wide, uniform, no scaling needed.
  // Operator-preferred over stretched DejaVu for the minor words. Budget:
  // 12 px/char -> max ~20 chars across the content width.
  void lbl4(int x, int y, word fg, const char* s) {
    setFontRaw(FONT_4, 1, 1, fg);
    textAt(x, y, s);
  }
  // centred within [x1,x2]
  void lblC(int x1, int x2, int y, bool bold, int sx, int sy, word fg, word bgc, const char* s) {
    int w = strW(s, bold, sx);
    int x = x1 + (x2 - x1 - w) / 2; if (x < x1) x = x1;
    lbl(x, y, bold, sx, sy, fg, bgc, s);
  }
  // right-aligned to x2
  void lblR(int x2, int y, bool bold, int sx, int sy, word fg, word bgc, const char* s) {
    lbl(x2 - strW(s, bold, sx), y, bold, sx, sy, fg, bgc, s);
  }

  // ---- raw, fully-framed reads (touch + font metrics) ----
  int readByteTO(int ms) {
    uint32_t t = millis();
    while (millis() - t < (uint32_t)ms) { if (Serial1.available()) return Serial1.read(); }
    return -1;
  }
  void drainQuiet(int quietMs) {
    uint32_t last = millis();
    while (millis() - last < (uint32_t)quietMs) { if (Serial1.available()) { Serial1.read(); last = millis(); } }
  }
  word rawCmdResp(word opcode, word arg) {
    drainQuiet(2);
    uint16_t op = (uint16_t)opcode;
    Serial1.write((uint8_t)(op >> 8)); Serial1.write((uint8_t)(op & 0xFF));
    Serial1.write((uint8_t)(arg >> 8)); Serial1.write((uint8_t)(arg & 0xFF));
    Serial1.flush();
    int ack = readByteTO(300);
    int hi  = readByteTO(300);
    int lo  = readByteTO(300);
    drainQuiet(3);
    if (ack != 0x06 || hi < 0 || lo < 0) { g_err++; return 0xFFFF; }
    return (word)((hi << 8) | lo);
  }
  // two-word-arg framed read (gfx_GetPixel x,y)
  word rawCmdResp2(word opcode, word a, word b) {
    drainQuiet(2);
    uint16_t op = (uint16_t)opcode;
    Serial1.write((uint8_t)(op >> 8)); Serial1.write((uint8_t)(op & 0xFF));
    Serial1.write((uint8_t)(a >> 8));  Serial1.write((uint8_t)(a & 0xFF));
    Serial1.write((uint8_t)(b >> 8));  Serial1.write((uint8_t)(b & 0xFF));
    Serial1.flush();
    int ack = readByteTO(300);
    int hi  = readByteTO(300);
    int lo  = readByteTO(300);
    drainQuiet(3);
    if (ack != 0x06 || hi < 0 || lo < 0) { g_err++; return 0xFFFF; }
    return (word)((hi << 8) | lo);
  }

  // charwidth/charheight take a single raw byte argument (lib source-verified)
  word rawCmdResp8(word opcode, byte arg) {
    drainQuiet(2);
    uint16_t op = (uint16_t)opcode;
    Serial1.write((uint8_t)(op >> 8)); Serial1.write((uint8_t)(op & 0xFF));
    Serial1.write(arg);
    Serial1.flush();
    int ack = readByteTO(300);
    int hi  = readByteTO(300);
    int lo  = readByteTO(300);
    drainQuiet(3);
    if (ack != 0x06 || hi < 0 || lo < 0) { g_err++; return 0xFFFF; }
    return (word)((hi << 8) | lo);
  }

  void measureCapMetrics() {
    // Render an 'E' and scan a window ABOVE and below the MoveTo point —
    // if the engine positions glyphs baseline-relative the ink sits above,
    // and capTop comes out negative. The centring math handles any sign.
    const int PX = 12, PY = 40;
    setFont(true, 1, 1, 0xFFFF, 0x0000);
    drain(); D->gfx_MoveTo(PX, PY);
    drain(); D->putCH('E');
    int top = 9999, bot = -9999;
    for (int y = PY - 20; y < PY + g_h8 + 8; y++) {
      for (int x = PX; x < PX + 12; x++) {
        if (rawCmdResp2(F_gfx_GetPixel, x, y) != 0x0000) {
          if (y < top) top = y;
          if (y > bot) bot = y;
          break;
        }
      }
    }
    if (bot >= top) { g_capTop8 = top - PY; g_capH8 = bot - top + 1; }
    drain(); D->gfx_RectangleFilled(0, PY - 22, 30, PY + g_h8 + 10, 0x0000);
  }

  void buildWidthCache() {
    const word fonts[2] = { FONT_7, FONT_8 };
    byte* tabs[2] = { g_w7, g_w8 };
    int*  hs[2]   = { &g_h7, &g_h8 };
    for (int f = 0; f < 2; f++) {
      drain(); D->txt_FontID(fonts[f]);
      g_font = fonts[f];
      for (int ch = 32; ch <= 126; ch++) {
        word w = rawCmdResp8(F_charwidth, (byte)ch);
        tabs[f][ch - 32] = (w == 0xFFFF) ? 8 : (byte)w;
      }
      word h = rawCmdResp8(F_charheight, (byte)'A');
      if (h != 0xFFFF) *hs[f] = (int)h;
    }
  }

  // host-side touch calibration (affine) — unchanged from the previous build
  float g_a = 0.972363f, g_b = 0.031048f, g_c = -7.2746f,
        g_d = 0.084970f, g_e = 0.989651f, g_f = -15.0600f;
  int clampi(int v, int lo, int hi) { return v < lo ? lo : (v > hi ? hi : v); }
  void applyCal(int rx, int ry, int* sx, int* sy) {
    *sx = clampi((int)(g_a * rx + g_b * ry + g_c + 0.5f), 0, DW - 1);
    *sy = clampi((int)(g_d * rx + g_e * ry + g_f + 0.5f), 0, DH - 1);
  }

  // partial-update caches for the operating screen
  int  g_lastTemp = -999;
  int  g_lastSens = -1;     // packed w|a|c|e bits (legacy 2x2 operating grid)
  int  g_lastOut  = -1;     // operating OUT dots (8 actuator bits)
  int  g_lastIn   = -1;     // operating IN dots (5 input bits)
  int  g_opWarn   = 0;      // LOW TEMP banner shown-state (operatingLowTemp)
  int  g_rdyTemp  = -9999;  // readiness temp cell cache (temp*2 + warn bit)
  word g_stripCol = 0;      // current state colour of the edge strip
  int  g_stripTop = 0;      // top y of the remaining (filled) strip portion

  // ---- shared chrome: edge strip + title (+ optional meta line) ----
  void chrome(const char* title, word stripColour, const char* meta) {
    word sc = remap(stripColour);
    bg(C_BG); cls();
    rect(0, 0, STRIP_W, DH - 1, sc);
    g_stripCol = sc; g_stripTop = 0;
    int tsx = (strW(title, true, 3) <= RX - LX) ? 3 : 2;
    lbl(LX, TITLE_Y, true, tsx, 3, C_TXT, C_BG, title);
    if (meta && *meta) lbl4(LX, META_Y, C_SUB, meta);
    hline(LX, RX, RULE1_Y, C_TRACK);
    rect(0, FOOT_Y, DW - 1, DH - 1, C_CARD);
  }
  void footerIP(const char* ip) {
    lbl(8, FOOT_Y + 3, false, 1, 1, C_SUB, C_CARD, ip);
    disc(FOOT_DOT_WEB_X, FOOT_DOT_Y, 4, C_TRACK); // web idle-grey at draw
    disc(FOOT_DOT_PUB_X, FOOT_DOT_Y, 4, C_RED);   // dots start "disconnected"
    disc(FOOT_DOT_SUB_X, FOOT_DOT_Y, 4, C_RED);   // until mqttIndicators() runs
  }

  // sensor grid (2 cols x 2 rows): dot + label. Used by readiness + operating.
  // Slot 2 (PRES) is the keg-side pressure switch downstream of the CO2
  // solenoid: open = unpressurized, which is NORMAL outside the PRESSURE
  // charge — so it renders grey, never red, and never gets fault emphasis.
  const char* SENS_LBL[4] = { "WATER", "AIR", "PRES", "E-STOP" };
  void sensorDot(int i, int y0, bool ok) {
    int x = LX + (i % 2) * 124, y = y0 + (i / 2) * 34;
    disc(x + 6, y + 13, 6, ok ? C_GRN : (i == 2 ? C_TRACK : C_RED));
  }
  void sensorGrid(int y0, bool w, bool a, bool c, bool e, bool emphasizeBad) {
    bool ok[4] = { w, a, c, e };
    for (int i = 0; i < 4; i++) {
      int x = LX + (i % 2) * 124, y = y0 + (i / 2) * 34;
      sensorDot(i, y0, ok[i]);
      word fg = (!ok[i] && emphasizeBad && i != 2) ? C_TXT : C_SUB;
      lbl(x + 19, y, false, 2, 2, fg, C_BG, SENS_LBL[i]);
    }
  }

  // Operating OUT/IN grid. OUT = the 8 actuators (bit order matches
  // hardware_getOutputBits): green = driven, grey = off. IN = the 5 inputs:
  // green = OK/made; PRES (index 2) grey when open (unpressurized is normal);
  // the rest red when lost (the active-resource monitor will abort anyway).
  const char* IO_OUT_LBL[8] = { "DRN", "WTR", "AIR", "CAU", "PMP", "SAN", "CO2", "HTR" };
  const char* IO_IN_LBL[5]  = { "WTR", "AIR", "PRES", "LVL", "STP" };
  void ioDotOut(int i, bool on) {
    int x = IO_X0 + (i % 4) * IO_OUT_PITCH, y = IO_R1_Y + (i / 4) * IO_ROW_H;
    disc(x + 4, y + 5, 4, on ? C_GRN : C_TRACK);
  }
  void ioDotIn(int i, bool ok) {
    int x = IO_X0 + i * IO_IN_PITCH, y = IO_R1_Y + 2 * IO_ROW_H;
    disc(x + 4, y + 5, 4, ok ? C_GRN : (i == 2 ? C_TRACK : C_RED));
  }
  void ioChrome() {   // static tags + labels; dots come from operatingIO()
    lbl(LX, IO_R1_Y, false, 1, 1, C_SUB, C_BG, "OUT");
    lbl(LX, IO_R1_Y + 2 * IO_ROW_H, false, 1, 1, C_SUB, C_BG, "IN");
    for (int i = 0; i < 8; i++) {
      int x = IO_X0 + (i % 4) * IO_OUT_PITCH, y = IO_R1_Y + (i / 4) * IO_ROW_H;
      lbl(x + 11, y, false, 1, 1, C_SUB, C_BG, IO_OUT_LBL[i]);
    }
    for (int i = 0; i < 5; i++) {
      int x = IO_X0 + i * IO_IN_PITCH, y = IO_R1_Y + 2 * IO_ROW_H;
      lbl(x + 11, y, false, 1, 1, C_SUB, C_BG, IO_IN_LBL[i]);
    }
  }

  // RTS-reset / baud-bump (unchanged, hardware-proven)
  void resetSync() {
    ConnectorCOM1.RtsMode(SerialBase::LINE_ON);  delay(200);
    ConnectorCOM1.RtsMode(SerialBase::LINE_OFF); delay(4500);   // Diablo16 boot
    ConnectorCOM1.Speed(9600);
    for (int i = 0; i < 12; i++) {
      drain(); uint32_t e = g_err; D->gfx_Cls();
      if (g_err == e) break;
      delay(200);
    }
    drain(); D->gfx_Set(SCREEN_MODE, PORTRAIT);
  }
  bool changeBaud(word rateIdx, uint32_t rawBaud) {
    drainQuiet(3);
    uint16_t op = (uint16_t)F_setbaudWait;                 // 38 = 0x0026
    Serial1.write((uint8_t)(op >> 8)); Serial1.write((uint8_t)op);
    Serial1.write((uint8_t)(rateIdx >> 8)); Serial1.write((uint8_t)rateIdx);
    Serial1.flush();                                       // fully transmit at the OLD baud first
    ConnectorCOM1.Speed(rawBaud);                          // RTS-safe host switch
    delay(130);                                            // display sleeps ~100ms then switches+ACKs
    drainQuiet(5);                                         // absorb the setbaud ACK / transition noise
    for (int i = 0; i < 4; i++) {                          // verify the link at the new baud
      drain(); uint32_t e = g_err; D->gfx_Cls();
      if (g_err == e) return true;
      delay(40);
    }
    resetSync();                                           // verify failed -> force known 9600 state
    return false;
  }
}

namespace KDS {

void begin() {
  Serial1.begin(9600);             // SPE boots at 9600; the lib object + handshake below
  Serial1.ttl(true);               // need it open before resetSync()'s handshake
  D = new Diablo_Serial_4DLib(&Serial1);
  D->Callback4D = onTO;
  D->TimeLimit4D = 1000;
  resetSync();                     // RTS-reset display -> SPE@9600, handshake, portrait
  changeBaud(BAUD_115200, 115200); // bump link to 115200 (~12x faster redraws; 9600 fallback)
  buildWidthCache();               // DejaVu glyph widths for centring (one-time, ~0.5 s)
  measureCapMetrics();             // render+readback: where caps sit in the cell
  drain(); D->txt_Set(TEXT_OPACITY, 0);   // transparent text (re-asserted by every cls())
}

uint32_t ackErrors() { return g_err; }

void startup(const char* l1, const char* l2) {
  chrome(l1, C_BLUE, l2);
  footerIP("booting");
}

// Unified readiness screen. Title + strip reflect overall readiness; failing
// inputs get a red dot + bright label. The caller adds START when allOk.
void readiness(bool water, bool air, bool co2, bool estop, bool level,
               bool allOk, const char* ip) {
  chrome(allOk ? "READY" : "NOT READY",
         allOk ? C_GRN : C_AMB,
         allOk ? "CONNECT KEGS" : "CHECK SYSTEMS");
  sensorGrid(94, water, air, co2, estop, true);
  // 5th gate — caustic LEVEL (this is in allSystemsGo but had no row, so a
  // low reservoir produced 'NOT READY but everything is green')
  int y5 = 94 + 2 * 34;
  disc(LX + 6, y5 + 13, 6, level ? C_GRN : C_RED);
  lbl(LX + 19, y5, false, 2, 2, (!level) ? C_TXT : C_SUB, C_BG, "LEVEL");
  g_rdyTemp = -9999;   // 6th cell (tank temp) redraws via readinessTemp()
  hline(LX, RX, 198, C_TRACK);
  footerIP(ip);
}

// Live tank temp in the readiness grid's free cell (row 3, col 1) — dot green
// at/above the wash floor, amber while the LOW TEMP warning is active.
// Change-detected: call every tick; draws only when the whole-°C value or the
// warn state moves (readiness() resets the cache on every full draw).
void readinessTemp(int tempC, bool warn) {
  int sig = tempC * 2 + (warn ? 1 : 0);
  if (sig == g_rdyTemp) return;
  g_rdyTemp = sig;
  int x = LX + 124, y = 94 + 2 * 34;
  disc(x + 6, y + 13, 6, warn ? C_AMB : C_GRN);
  char b[10];
  snprintf(b, sizeof(b), "%dC", tempC);
  // Full-height clear: 2x glyphs are ~24 px tall — an undersized rect left
  // the bottoms of the previous digits behind ("crumbly" readings).
  rect(x + 17, y - 2, RX, y + 26, C_BG);
  lbl(x + 19, y, false, 2, 2, warn ? C_AMB : C_SUB, C_BG, b);
}

void notReady(bool water, bool air, bool co2, bool estop, const char* ip) {
  readiness(water, air, co2, estop, true, false, ip);
}
void ready(const char* ip) { readiness(true, true, true, true, true, true, ip); }

void heating(int curC, int tgtC, int pct, const char* ip) {
  chrome("HEATING", C_BLUE, "HEATING CAUSTIC");
  char b[24];
  snprintf(b, sizeof(b), "%dF %dC", (curC * 9 + 2) / 5 + 32, curC);
  rect(LX - 2, TMR_Y, RX, TMR_CLR_Y2, C_BG);
  lbl(LX, TMR_Y, true, 3, 4, C_TXT, C_BG, b);
  snprintf(b, sizeof(b), "TARGET %dF %dC", (tgtC * 9 + 2) / 5 + 32, tgtC);
  rect(LX - 2, REM_Y, RX, REM_Y + 28, C_BG);
  lbl4(LX, REM_Y, C_SUB, b);
  hline(LX, RX, RULE2_Y, C_TRACK);
  snprintf(b, sizeof(b), "%d%%", pct);
  rect(LX - 2, TMP_Y, RX, TMP_CLR_Y2, C_BG);
  lbl(LX, TMP_Y, true, 2, 2, C_CYAN, C_BG, b);
  lbl4(LX, TMPSUB_Y, C_SUB, "OF HEAT WINDOW USED");
  footerIP(ip);
}

// Operating frame: phase name + position + description, countdown + temp
// fields, sensor grid. Partial updates fill the fields afterwards.
void operatingFrame(const char* phaseName, const char* desc,
                    int phaseIdx, int phaseCount,
                    const char* ip, word stateColour) {
  char meta[24];
  snprintf(meta, sizeof(meta), "%d/%d %s", phaseIdx, phaseCount, desc);
  chrome(phaseName, stateColour, meta);
  lbl4(LX, REM_Y, C_SUB, "REMAINING");
  hline(LX, RX, RULE2_Y, C_TRACK);
  lbl4(LX, TMPSUB_Y, C_SUB, "CAUSTIC");
  hline(LX, RX, RULE3_Y, C_TRACK);
  ioChrome();                               // OUT/IN tags + labels; dots follow
  g_lastTemp = -999; g_lastOut = g_lastIn = -1;   // force first partial update
  g_opWarn = 0;                             // frame drew REMAINING, no banner
  footerIP(ip);
}

// Steady LOW TEMP warning on the operating screen — banner zone (which holds
// only the REMAINING label here; the label is restored on hide). Shown-state
// lives HERE so every operatingFrame() repaint (phase change, resume, restart)
// resets it — callers can invoke this every tick, it no-ops when unchanged.
void operatingLowTemp(bool show) {
  if ((int)show == g_opWarn) return;
  g_opWarn = show ? 1 : 0;
  banner("LOW TEMP", C_AMB, show);
  if (!show) lbl4(LX, REM_Y, C_SUB, "REMAINING");
}
// legacy 3-arg form (KegDisplay migrates to the rich one; keep compiling)
void operatingFrame(const char* stateName, const char* ip, word barColour) {
  operatingFrame(stateName, "", 0, 0, ip, barColour);
}

// Edge strip as overall-cycle countdown: the state-coloured bar drains from
// the top as total cycle time elapses (full = cycle start, empty = done).
void cycleProgress(unsigned long cycleElapsedMs, unsigned long cycleTotalMs) {
  if (cycleTotalMs == 0) return;
  if (cycleElapsedMs > cycleTotalMs) cycleElapsedMs = cycleTotalMs;
  int top = (int)((unsigned long long)DH * cycleElapsedMs / cycleTotalMs);
  if (top == g_stripTop) return;
  if (top > g_stripTop) rect(0, g_stripTop, STRIP_W, top, C_TRACK);
  else                  rect(0, top, STRIP_W, g_stripTop, g_stripCol);
  g_stripTop = top;
}

void operatingTimer(int minutes, int seconds) {
  char b[8];
  snprintf(b, sizeof(b), "%02d:%02d", minutes, seconds);
  rect(LX - 2, TMR_Y, RX, TMR_CLR_Y2, C_BG);
  lbl(LX, TMR_Y, true, 4, 5, C_TXT, C_BG, b);
}

// Temp partial update (extracted from the legacy operatingStatus).
void operatingTemp(int tempC10) {
  if (tempC10 == g_lastTemp) return;
  g_lastTemp = tempC10;
  // tenths-of-a-degree input so F gets real precision (1 C = 1.8 F steps)
  int f10 = tempC10 * 9 / 5 + 320;
  int f = (f10 >= 0) ? (f10 + 5) / 10 : (f10 - 5) / 10;
  int c = (tempC10 >= 0) ? (tempC10 + 5) / 10 : (tempC10 - 5) / 10;
  char b[16];
  snprintf(b, sizeof(b), "%dF %dC", f, c);
  rect(LX - 2, TMP_Y, RX, TMP_CLR_Y2, C_BG);
  lbl(LX, TMP_Y, true, 2, 2, C_GRN, C_BG, b);
}

// OUT/IN dot partial update — per-dot change detection (serial link economy).
void operatingIO(byte outBits, byte inBits) {
  if ((int)outBits != g_lastOut) {
    for (int i = 0; i < 8; i++) {
      bool on = outBits & (1 << i);
      if (g_lastOut < 0 || on != (bool)(g_lastOut & (1 << i))) ioDotOut(i, on);
    }
    g_lastOut = outBits;
  }
  if ((int)inBits != g_lastIn) {
    for (int i = 0; i < 5; i++) {
      bool ok = inBits & (1 << i);
      if (g_lastIn < 0 || ok != (bool)(g_lastIn & (1 << i))) ioDotIn(i, ok);
    }
    g_lastIn = inBits;
  }
}

void operatingStatus(int tempC10, bool water, bool air, bool co2, bool estop, bool mqtt) {
  (void)mqtt;   // footer dots are driven by mqttIndicators()
  if (tempC10 != g_lastTemp) {
    g_lastTemp = tempC10;
    // tenths-of-a-degree input so F gets real precision (1 C = 1.8 F steps)
    int f10 = tempC10 * 9 / 5 + 320;
    int f = (f10 >= 0) ? (f10 + 5) / 10 : (f10 - 5) / 10;
    int c = (tempC10 >= 0) ? (tempC10 + 5) / 10 : (tempC10 - 5) / 10;
    char b[16];
    snprintf(b, sizeof(b), "%dF %dC", f, c);
    rect(LX - 2, TMP_Y, RX, TMP_CLR_Y2, C_BG);
    lbl(LX, TMP_Y, true, 2, 2, C_GRN, C_BG, b);
  }
  int packed = (water << 3) | (air << 2) | (co2 << 1) | (int)estop;
  if (packed != g_lastSens) {
    g_lastSens = packed;
    sensorDot(0, SENS_Y, water); sensorDot(1, SENS_Y, air);
    sensorDot(2, SENS_Y, co2);   sensorDot(3, SENS_Y, !estop ? true : false);
  }
}

void finished(const char* ip) {
  chrome("COMPLETE", C_BLUE, "KEGS DONE - SWAP");
  // 3x3 (39 px) sits evenly in the banner(126)..START(180) gap
  lbl(LX, 133, true, 3, 3, C_GRN, C_BG, "DONE");
  footerIP(ip);
}

void error(const char* msg, const char* ip) {
  chrome("FAULT", C_RED, "MACHINE MADE SAFE");
  // wrap the message manually at ~28 chars (F7 is proportional but this is
  // a safe budget for 240 px)
  char line[24];
  int y = 92;
  const char* p = msg;
  while (*p && y < 200) {
    int n = 0;
    int lastSp = -1;
    while (p[n] && n < 20) { if (p[n] == ' ') lastSp = n; n++; }
    if (p[n] && lastSp > 0) n = lastSp;
    memcpy(line, p, n); line[n] = 0;
    lbl4(LX, y, C_TXT, line);
    y += 20;
    p += n; while (*p == ' ') p++;
  }
  footerIP(ip);
}

void stopping(const char* ip) {
  chrome("STOPPING", C_AMB, "PURGING KEG");
  lbl4(LX, REM_Y, C_SUB, "TIME LEFT");
  footerIP(ip);
}

void halted(const char* ip) {
  chrome("STOPPED", C_AMB, "HALTED BY OPERATOR");
  lbl4(LX, 150, C_SUB, "GET READY = RE-ARM");
  footerIP(ip);
}

void message(const char* msg, const char* ip) {
  chrome("MESSAGE", C_BLUE, "");
  lbl4(LX, 84, C_TXT, msg);
  footerIP(ip);
}

void touchEnable() { drain(); D->touch_Set(TOUCH_ENABLE); }

void mark(int x, int y) { disc(x, y, 7, C_TXT); disc(x, y, 3, C_RED); }

void mqttIndicators(bool connected, bool pubActive, bool subActive,
                    bool webActive) {
  word pc = !connected ? C_RED : (pubActive ? C_AMB : C_DIMGRN);
  word sc = !connected ? C_RED : (subActive ? C_CYAN : C_DIMGRN);
  disc(FOOT_DOT_WEB_X, FOOT_DOT_Y, 4, webActive ? C_GRN : C_TRACK);
  disc(FOOT_DOT_PUB_X, FOOT_DOT_Y, 4, pc);
  disc(FOOT_DOT_SUB_X, FOOT_DOT_Y, 4, sc);
}

void footer(const char* ip) { rect(0, FOOT_Y, DW - 1, DH - 1, C_CARD); footerIP(ip); }

// alert banner in the reserved zone under the rule (flash-toggled by caller)
void banner(const char* text, word colour, bool visible, int y1, int y2) {
  if (y1 < 0) y1 = BANNER_Y1;
  if (y2 < 0) y2 = BANNER_Y2;
  word c = remap(colour);
  if (visible) {
    rrect(16, y1, 256, y2, 8, c);
    int sx = (strW(text, true, 2) <= 228) ? 2 : 1;
    int ty = (y1 + y2) / 2 - 2 * (2 * g_capTop8 + g_capH8) / 2;
    lblC(16, 256, ty, true, sx, 2, inkOn(c), c, text);
  } else {
    rect(10, y1 - 2, 260, y2 + 2, C_BG);
  }
}

// Shared label-fit: target multiplier by height, shrink width-mult to fit.
static void buttonLabel(int x, int y, int w, int h, const char* label,
                        word ink, word fill, bool heavy) {
  // Balanced scales only (NxN) — mixed sx/sy stretching looks skinny/squat.
  int s = (h >= 90) ? 4 : (h >= 40) ? 3 : 2;
  while (s > 1 && strW(label, true, s) > w - 14) s--;
  int tw = strW(label, true, s);
  int tx = x + (w - tw) / 2; if (tx < x + 2) tx = x + 2;
  // Centre the measured CAPS block (panel-measured metrics, not the cell):
  // caps span ty + capTop*s .. ty + (capTop+capH)*s.
  int ty = y + h / 2 - s * (2 * g_capTop8 + g_capH8) / 2;
  if (heavy) ty -= s / 4;        // overstrike adds ink below; re-balance
  if (ty < y + 2) ty = y + 2;
  lbl(tx, ty, true, s, s, ink, fill, label);
  if (heavy) {
    // overstrike grid scales with size: meaningfully heavier strokes that
    // also fill the NN-scaling stairsteps
    for (int dx = 1; dx < s; dx++)       lbl(tx + dx, ty, true, s, s, ink, fill, label);
    for (int dy = 1; dy <= s / 2; dy++) {
      lbl(tx, ty + dy, true, s, s, ink, fill, label);
      for (int dx = 1; dx < s; dx++)     lbl(tx + dx, ty + dy, true, s, s, ink, fill, label);
    }
  }
}

// Secondary button: dark card fill, coloured bold label (direction-C default).
void button(int x, int y, int w, int h, const char* label, word colour) {
  word accent = remap(colour);
  if (accent == C_TRACK || accent == 0x4208) accent = C_SUB;   // disabled nav
  rrect(x, y, x + w, y + h, 8, C_CARDHI);
  buttonLabel(x, y, w, h, label, accent, C_CARDHI, false);
}

// Primary button: solid semantic fill, dark label. For THE action on a screen.
void buttonPrimary(int x, int y, int w, int h, const char* label, word colour) {
  word fill = remap(colour);
  rrect(x, y, x + w, y + h, 10, fill);
  buttonLabel(x, y, w, h, label, inkOn(fill), fill, true);
}

// ---- generic primitives (settings editor / boot screen in KegDisplay) ----
void screen(const char* title, word barColour) { chrome(title, barColour, ""); }
void text(int x, int y, int sz, word fg, word bg, const char* s) {
  lbl(x, y, false, sz, sz, remap(fg), bg == 0x4208 ? C_CARD : bg, s);
}
void label(int x, int y, bool bold, int sx, int sy, word fg, word bg, const char* s) {
  lbl(x, y, bold, sx, sy, remap(fg), bg, s);
}
void label4(int x, int y, word fg, word bg, const char* s) {
  (void)bg;
  lbl4(x, y, remap(fg), s);
}
void fontMetrics(int* cell, int* capTop, int* capH) {
  if (cell)   *cell   = g_h8;
  if (capTop) *capTop = g_capTop8;
  if (capH)   *capH   = g_capH8;
}
void labelRight(int x2, int y, bool bold, int sx, int sy, word fg, word bg, const char* s) {
  lblR(x2, y, bold, sx, sy, remap(fg), bg, s);
}
void rule(int y) { hline(LX, RX, y, C_TRACK); }
void fillRect(int x, int y, int x2, int y2, word col) { rect(x, y, x2, y2, col); }

bool touch(int* x, int* y) {
  static bool down = false;
  word st = rawCmdResp(F_touch_Get, TOUCH_STATUS);
  if (st == TOUCH_PRESSED) {
    int tx = rawCmdResp(F_touch_Get, TOUCH_GETX);
    int ty = rawCmdResp(F_touch_Get, TOUCH_GETY);
    if (!down) { down = true; applyCal(tx, ty, x, y); return true; }
  } else if (st == TOUCH_RELEASED || st == NOTOUCH) {
    down = false;
  }
  return false;
}

bool touchRaw(int* x, int* y) {
  word st = rawCmdResp(F_touch_Get, TOUCH_STATUS);
  if (st == TOUCH_PRESSED || st == TOUCH_MOVING) {
    *x = rawCmdResp(F_touch_Get, TOUCH_GETX);
    *y = rawCmdResp(F_touch_Get, TOUCH_GETY);
    return true;
  }
  return false;
}

void setTouchCalibration(float a, float b, float c, float d, float e, float f) {
  g_a = a; g_b = b; g_c = c; g_d = d; g_e = e; g_f = f;
}

} // namespace KDS
