RobotBuzzard/KegWasher/(commit log)

2026-05-06 Initial project scaffold
    Add README, MIT LICENSE, Arduino-flavored .gitignore, the original
    state-table snapshot for diff reference, and the example SD config.
    Source modules and the updated design docs land in follow-up commits
    as the merge of the prior baseline + enhanced + reliability variants
    is consolidated.
2026-05-07 Add design docs and KegConfig module
    docs/: state-table, io-table, reliability-todo migrated from prior
    artifacts under canonical names.
    src/KegConfig.{h,cpp}: consolidated single source of truth for pins,
    state IDs, error codes, and SD config. STATE_ERROR moved from 9 to 7
    to fix the stateNames[] OOB read; KegDiagnostics.h's duplicate error
    defines will be removed in a follow-up. Adds bounded validation on
    timer/largeKegMod values so config typos log a warning and fall back
    to defaults instead of silently misbehaving.
    [KegConfig.cpp, KegConfig.h]
2026-05-07 Add KegHardware module
    Merged the heater-aware base with reliability features from the
    "improved" hardware draft, leaving out the fake "redundant sensor"
    that was just random noise added to a single reading.
    Notable changes vs prior versions:
    - ESTOP ISR no longer calls diagnostics_logEvent or writes CCIO
    outputs (both go via Serial transactions and can deadlock from
    an ISR). The ISR now just lights the alarm, kills ClearCore-native
    outputs (co2Out), and sets a flag for the main loop. CCIO outputs
    rely on the hardware ESTOP loop physically de-powering them, per
    README.
    - Inputs (except ESTOP) are debounced via a per-pin 50ms IIR.
    - Analog reads are validated (reject ~0 / ~4095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
    [KegHardware.cpp, KegHardware.h]
2026-05-07 Add KegStateMachine module
    Consolidated the enhanced + air-burst variant. Behavior matches the
    state-table and state-table-original diff. Notable changes vs prior
    versions:
    - stateNames[] now sized NUM_STATES; the prior STATE_ERROR=9 + 8-entry
    array was a latent OOB read (fixed by moving STATE_ERROR to 7 in
    KegConfig.h).
    - Per-state hard timeout (Priority 4 from reliability-todo). Operator-
    acknowledged states (FINISHED, ERROR) have no timeout. Anything else
    that overruns its bound transitions to ERROR with ERR_STATE_TIMEOUT
    rather than wedging.
    - changeState() factored into exitState/enterState helpers. enterState
    for WASHING checks caustic temp and redirects to ERROR on fail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
    [KegStateMachine.cpp, KegStateMachine.h]
2026-05-07 Add KegTimers, KegDisplay, KegDiagnostics, KegUtils
    Smaller modules, mostly preserved from prior versions. Notable changes:
    KegDiagnostics:
    - Removed duplicate error-code defines (canonical home is KegConfig.h);
    the module now just consumes them.
    - diagnostics_logEvent() now writes to USB Serial instead of clobbering
    the operator display every state transition. Requires Serial.begin()
    in the .ino — handled in the next commit.
    - getErrorMessage() now covers the 6 error codes added since the
    baseline (heating timeout/rate, caustic level, heater overtemp,
    state timeout, sensor fault).
    - diagnostic-mode entry is now gated to STATE_STARTUP / STATE_FINISHED
    so an operator can't acci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
    [KegDiagnostics.cpp, KegDiagnostics.h, KegDisplay.cpp, KegDisplay.h, KegTimers.cpp, KegTimers.h, KegUtils.cpp, KegUtils.h]
2026-05-07 Add KegWasher.ino main sketch
    Init order corrected:
    - Serial.begin() first so diagnostics_logEvent() output works for the
    remainder of setup.
    - display_init() before config_init() / hardware_init() etc., so any
    failure in those modules has a screen to render the error on. The
    Goldelox boot sequence (~4s with the RTS toggle and boot delay) is
    the longest step in setup, so doing it first amortises into the
    rest of init.
    ESTOP handling cleaned up:
    - The ISR already kills safety-critical outputs. The main loop just
    consumes the flag, calls the full hardware_allStop() (which is
    non-ISR-safe because of CCIO Serial), logs, and transitions the
    state machine. The previous double-fire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
    [KegWasher.ino]
2026-05-07 Add Priority 0: bring-up, docs, long-term stability
    Captures the immediate-next-steps that have to land before the
    existing Priority 1-6 work means anything in production:
    - Verify the firmware actually compiles and flashes on the
    ClearCore via USB, with diagnostic mode validating I/O before
    any wet test.
    - Per-state display pages, since the current "every handler
    writes the screen" pattern can't keep up with the 9600-baud
    Goldelox link.
    - Hardware watchdog — check whether the ClearCore Arduino API
    exposes the SAMD51 WDT, and figure out where to put wdt_reset()
    given the long delay()s in diagnostic mode.
    - Reference docs index — single place to find ClearCore, CCIO-8,
    SAMD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
2026-05-07 Flatten layout to Arduino sketch convention; fix Display init
    The src/ subfolder broke arduino-cli's sketch-folder-equals-ino-name
    rule. Moved every Keg*.{h,cpp,ino} up to the project root so the
    canonical sketch path is /KegWasher/KegWasher.ino. Updated README.
    Two compile fixes surfaced when the build finally ran:
    - KegDisplay.cpp used Display.println() with no args, but the
    Goldelox library has no zero-arg println overload (the inherited
    Print::println isn't visible). Replaced with println("").
    - KegDisplay.cpp referenced an undefined DisplaySerial symbol. The
    ClearCore Arduino API exposes the COM1 stream as Serial1 (Uart)
    with ConnectorCOM1 as the underlying SerialDriver. Now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
    [KegConfig.cpp, KegConfig.h, KegDiagnostics.cpp, KegDiagnostics.h, KegDisplay.cpp, KegDisplay.h, KegHardware.cpp, KegHardware.h]
2026-05-07 Add tests/DisplayTest smoke sketch
    Minimal Goldelox + ClearCore "hello world" — boots the display via
    the COM1 RTS reset, writes "TEST" in 3x text. No CCIO, no SD, no
    sensors, no state machine. Useful for confirming the toolchain and
    the display wiring independent of the main firmware.
    Compiles to 26% flash / 9 KB globals.
    [DisplayTest.ino]
2026-05-07 reliability-todo: check off toolchain bring-up
    Toolchain compile + flash is now verified end-to-end. The canonical
    project-agnostic procedure lives in:
    https://github.com/RobotBuzzard/teknic-clearcore-cli
    That repo captures the arduino-cli + Teknic platform install, the
    Linux gotchas (ModemManager, dialout, udev probing the bootloader's
    mass-storage interface, port-holders like the IDE Serial Monitor),
    and a BlinkLED smoke test that round-trips successfully.
    Sub-items remaining under this Priority 0 entry:
    - Flash full KegWasher.ino and confirm boot sequence on display
    (gated on physical-mounting fix for the Goldelox)
    - Run diagnostic mode (DRAIN + START hold) for I/O exercise
    Co-Aut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
2026-05-07 Fix display first-char drop, fan PWM thrash, and add ack/reset split
    Three bench-discovered issues from the first full firmware flash:
    1. Goldelox first-character drop. The display ate the first byte of
    every Display.println() call after a CR/LF — "ERROR" rendered as
    "RROR", "Press START to reset" as "ress START to res", etc. This
    is a known quirk where the display is briefly cursor-advancing
    when the next byte arrives.
    Added display_println() wrappers in KegDisplay (h+cpp) that
    prepend a sacrificial space, and converted the affected call
    sites in KegDisplay.cpp and KegDiagnostics.cpp. Numeric-end-of-
    line and within-line print() calls keep using Display.println /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
    [KegDiagnostics.cpp, KegDisplay.cpp, KegDisplay.h, KegHardware.cpp, KegStateMachine.cpp]
2026-05-07 Fix Goldelox first-char drop on embedded newlines
    display_println()'s sacrificial-space workaround only protects the
    *first* character of the call; if the string itself contains an
    embedded "\n", the byte after that newline gets eaten by the same
    quirk because the wrapper isn't there for it.
    That's why "\nPress START to reset" was still rendering as
    "ress START to res" even after the wrapper landed.
    Split such strings into separate display_println() calls — each
    gets its own protection. Affected display_showError() and
    display_showStartup().
    [KegDisplay.cpp]
2026-05-07 Fit error-screen prompt to Goldelox 17-char line limit
    Default text size in portrait fits ~17 chars per line; "Press START
    to reset" was being right-edge-cropped to "Press start to re". Split
    the prompt onto two lines and document both buttons so the operator
    knows DRAIN silences and a held START resets.
    [KegDisplay.cpp]
2026-05-07 Swap alarmOut and cabinFanPWM (IO4/IO5) to match bench wiring
    The bench has the cabinet fan physically on IO5 and the alarm on IO4
    — opposite of the original io-table. Both pins support PWM on the
    ClearCore (SAME53 TCC channels are wired to all six bidirectional
    IOs), so the assignment is wiring-driven, not hardware-mandated.
    Symptom that surfaced this: pressing DRAIN in the error state silenced
    the alarm via hardware_setAlarm(false), which drove IO5 LOW — turning
    off the fan that was actually wired there.
    Updated KegConfig.h and docs/io-table.md to match the as-wired
    hardware.
    [KegConfig.h]
2026-05-07 Rename "MadMoon Keg Washer" → "Robot Keg Washer"
    Original buyer (MadMoon) didn't complete payment. Project is being
    finished and re-marketed under the Reasonable Robot Repair brand.
    "Robot Keg Washer" is 16 chars — fits the Goldelox 17-char/line
    limit at default font with the wrapper's leading sacrificial space.
    Replaced 4 occurrences in KegDisplay.cpp (display_showStartup,
    display_update, display_showMessage, display_showProgress).
    Flashed and verified on the bench via teknic-clearcore-cli's
    flash.sh.
    [KegDisplay.cpp]
2026-05-07 Housekeeping: mark shipped reliability items, tag hardware-gated work
    The TODO doc had a backlog of Priority 1-6 items that were already
    delivered in the merge but still showed as open. This commit
    reconciles the doc with reality so it's a real roadmap rather than
    a stale wishlist.
    Marked done in the merge (✓):
    - P1 Input debouncing
    - P1 Sensor validation + filtering
    - P3 Configuration validation
    - P3 Individual setting fallbacks
    - P4 State timeouts
    - P5 Millis overflow handling
    Tagged hardware-gated (won't progress without wiring changes):
    - P1 Output verification — needs feedback inputs
    - P1 Redundant sensors — needs second physical sensor per channel
    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
2026-05-08 Add hardware watchdog (8 sec timeout) — bench-validated
    Teknic's ClearCore Arduino library does NOT expose any watchdog API
    (verified against teknic-inc.github.io/ClearCore-library/ — SysManager
    has only ConnectorByIndex and ResetBoard). Going direct to the SAME53
    WDT register block via the CMSIS headers Arduino.h already pulls in.
    Implementation:
    - KegWatchdog.h/cpp — enable/disable/kick/isEnabled/lastResetCause
    API with direct register access. SAMD51 WDT is fed from
    OSC32KCTRL's CLK_OSC32K_1K (1024 Hz tap from OSCULP32K) — no GCLK
    channel manipulation needed (unlike SAMD21).
    - 8 second timeout via WDT_CONFIG_PER_CYC8192. Generous over our
    10ms loop period; shor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
    [KegDiagnostics.cpp, KegWasher.ino]
2026-05-08 Migrate watchdog to published ClearCoreWatchdog library
    The watchdog code we built and bench-validated has been spun out
    into a standalone Arduino library:
    https://github.com/RobotBuzzard/ClearCoreWatchdog
    KegWasher now consumes it as a third-party dependency rather than
    carrying its own copy. Validates the library is genuinely usable as
    a drop-in (it compiles, flashes, and runs identically to the in-tree
    version — same 170916-byte binary).
    Changes:
    - Removed KegWatchdog.h / KegWatchdog.cpp from the repo
    - KegWasher.ino: #include <ClearCoreWatchdog.h>; method calls
    Watchdog.enable() / .kick() / .lastResetCause() instead of the
    free-function API
    - KegDiagnostics.cpp: same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
2026-05-08 reliability-todo: add bench-mode override as a Priority 0 item
    Without sensors wired, hardware_allSystemsGo() fails immediately on
    ERR_AIR_PRESSURE and the firmware lands in ERROR. That blocks every
    downstream bench validation we'd want to do: confirming the boot
    reaches "Press START" on the display, exercising diagnostic mode
    (gated to STARTUP/FINISHED), watching state timeouts and output
    relays cycle through a real run, etc.
    Adding a Priority 0 entry for a compile-time BENCH_MODE flag that
    bypasses systems-go gates while leaving heater interlocks intact
    (those are hardware-safety, not policy). Build-flag-gated so the
    shipped firmware is byte-identical to today.
    Also cross-referenced the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
2026-05-08 Add BENCH_MODE compile flag (development only)
    When BENCH_MODE is defined in KegConfig.h, the firmware bypasses
    the sensor-driven gates that otherwise refuse to run a cycle on
    a bench rig with nothing wired. The state machine actually
    progresses through DRAINING → RINSING → WASHING → SANITIZE →
    PRESSURE → FINISHED with output relays toggling visibly.
    Bypassed:
    - hardware_allSystemsGo() returns true unconditionally
    - STARTUP_HEATING substate is skipped (INIT → IO_CHECK direct)
    - enterState(STATE_WASHING) skips its precondition caustic-temp check
    - state_washing() skips the per-tick caustic-temp check
    NOT bypassed (hardware-safety, not policy):
    - hardware_setCausticHeat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
    [KegConfig.h, KegDisplay.cpp, KegHardware.cpp, KegStateMachine.cpp, KegWasher.ino]
2026-05-14 Bench-mode: 5s timers, state_finished render, ESTOP polarity fix
    Five related changes, all bench-validated end-to-end against the
    camera-monitored bench rig. With this commit the full cycle runs
    visibly in ~25 seconds when BENCH_MODE is enabled.
    1. BENCH_MODE timer override (KegConfig.cpp)
    When BENCH_MODE is defined, stage timer defaults compile to 5000 ms
    instead of 180000 ms. The validation bounds [30s, 30min] still
    apply to SD-loaded values — the override only changes compiled
    defaults. Production builds (BENCH_MODE undefined) are unaffected.
    2. state_finished now renders (KegStateMachine.cpp)
    Previously had no display call of its own — the screen stuck on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
    [KegConfig.cpp, KegHardware.cpp, KegStateMachine.cpp, KegWasher.ino]
2026-05-14 README: prominent pre-production / bench-only warnings
    KegConfig.h currently ships with BENCH_MODE active (uncommented).
    The firmware in this state is NOT safe to run on a real cleaner —
    sensor checks are deliberately bypassed so the state machine can
    be exercised on a bare workbench.
    Adding three explicit-state callouts so no one (including future-
    me) mistakes this for a production-ready release:
    1. Top-of-README warning box right under the one-liner intro,
    listing the five gates that must close before connecting real
    plumbing or chemicals.
    2. Rewritten Status section: "v0.1-bench — works on a workbench,
    not yet on a real machine." Enumerates exactly what's been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
2026-05-14 Add comprehensive TODO.md as the live project roadmap
    A phase-organised, actionable next-steps list separate from
    docs/reliability-todo.md (which stays as the deeper per-item
    reference with code examples).
    Phases reflect the real path from where we are now:
    Phase 0 Ethernet & remote access (active — cable just plugged in)
    Phase 1 Hardware bring-up (gated on real machine existing)
    Phase 2 Wet testing (water-only → caustic → full chemistry)
    Phase 3 Pre-production hardening (display refactor, power-fail
    recovery, config checksums, state history, SD logging,
    heap/loop monitoring, reference docs index)
    Phase 4 Long-term stability (display health check,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
2026-05-14 Phase 0 #1: Ethernet + DHCP init
    Brings the ClearCore onto the LAN at boot. Uses the platform's stock
    Arduino-style Ethernet API (<Ethernet.h>); DHCP with empty MAC array
    so the library uses the chip's burned-in MAC.
    Timing notes:
    - 3 s link-up wait, then bails to offline mode if the cable's
    unplugged (bench may not have it wired)
    - DHCP runs BEFORE Watchdog.enable() because lwIP's default DHCP
    timeout is in the tens of seconds, well over an 8 s WDT
    - Ethernet.maintain() called once per loop iteration to renew the
    DHCP lease; no-op if no lease
    Verified on bench: ClearCore gets 192.168.1.92, ping responds with
    ~7 ms RTT, full boot log captures "Ethernet: IP=192.168.1.92" a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
    [KegWasher.ino]
2026-05-14 IP footer + HTTP-connection-indicator framework on every screen
    Adds a one-line footer at the bottom of every persistent screen:
    192.168.1.92 (when Ethernet has a lease)
    192.168.1.92 * (when one or more HTTP clients connected)
    offline (when no link / no DHCP)
    The '*' indicator is read from a new volatile uint8_t kwHttpClients
    counter that's defined now but always 0 — it'll start flipping when
    the HTTP server lands in Phase 0 #3+. The slot is wired so the
    plumbing change can be a one-line increment/decrement in the server.
    - KegWasher.ino: kwLocalIP is now uint8_t[4] (was IPAddress) so
    KegDisplay.cpp can read it without pulling <Etherne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
    [KegDisplay.cpp, KegDisplay.h, KegStateMachine.cpp, KegWasher.ino]
2026-05-14 Phase 0 #2: MQTT log mirror + online/ip retained topics
    Replaces the planned UDP-broadcast log mirror with MQTT (PubSubClient),
    on the basis that we already have a Mosquitto broker on the LAN and
    MQTT is strictly more useful: retained topics, LWT, pub/sub semantics
    for the upcoming control plane, and trivial integration with the
    brewery's existing automation tooling.
    Topics this commit publishes (more in subsequent commits):
    kegwasher/log QoS 0, no retain — every diagnostics_logEvent line
    is mirrored here in real time. Tail with
    `mosquitto_sub -h <broker> -u <user> -t kegwasher/#`.
    kegwasher/online retained — "true" on connect, "false"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
    [KegConfig.h, KegDiagnostics.cpp, KegWasher.ino]
2026-05-14 TODO: pivot Phase 0 from on-device HTTP to MQTT pub/sub + Node-RED
    Decided 2026-05-14: no HTTP server on the ClearCore. All remote
    status and control flows through MQTT topics, with a Node-RED
    operator dashboard on CheapBourbon (.111, same host as Mosquitto)
    consuming those topics.
    Rationale:
    - Fewer protocols on the firmware — one TCP connection, one
    library (PubSubClient), one auth path (the broker).
    - LWT + retained topics give us "is it alive?" and "what's it
    doing right now?" for free. A fresh subscriber sees the last
    known state without polling.
    - Pub/sub composes — multiple consumers (operator UI on the Pi,
    phone notification, future Grafana panels) attach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
2026-05-14 Display: purple "M*" footer indicator when MQTT is connected
    Adds a small "M*" status icon in the bottom-right corner of every
    screen that calls display_footer(), shown only while the firmware
    holds a live connection to the MQTT broker. Operator gets an at-a-
    glance signal that the remote-control / log-mirror path is up
    without needing to check the broker side.
    Plumbing:
    - kwMqttReady boolean global in KegWasher.ino, set true in
    mqtt_try_connect after a successful publish of the retained
    online=true announce, and cleared in mqtt_loop the first time
    PubSubClient.connected() returns false. Mirrors the kwEthernet
    Ready / kwLocalIP convention so the display module reads
    n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
    [KegDisplay.cpp, KegDisplay.h, KegWasher.ino]
2026-05-15 Display: bump Goldelox link 9600 -> 115200 with custom baud handler
    Drops full-screen redraw time from ~400 ms (UART-bound at 9600) to
    ~35 ms — visually instant repaints on every state transition instead
    of watching characters paint on. The display update interval stays
    at 1 Hz so the steady-state cost is the same; it's the discrete
    moments-of-change that get the win.
    The fix isn't quite the obvious one. The library's stock
    hwSetBaudRateHndl calls Serial1.end() on the way through, and on
    ClearCore Serial1.end() routes to SerialBase::PortClose() which
    contains:
    DATA_DIRECTION_INPUT(m_rtsSsInfo->gpioPort, 1L << m_rtsSsInfo->gpioPin);
    i.e. it switches the RTS pin from output to input mid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
    [KegDisplay.cpp, KegStateMachine.cpp]
2026-05-15 docs: add display-guide.md
    A practical reference for working with the Goldelox 128x128 over
    COM1: the hardware path, the boot/baud-negotiation sequence, the
    wrapper API and why it exists, screen layout with the 16x10
    character grid, footer composition with status icon slots, the
    render-once pattern, the failure modes table, and a short
    "adding a new screen" checklist.
    Captures the non-obvious bits that bit us during bring-up so the
    next contributor (or future me) doesn't relearn them:
    - RTS-as-reset wiring and the PortClose-floats-RTS pitfall when
    changing baud — the single sharpest edge on this hardware.
    - The sacrificial-space trick around the Goldelox first-char
    drop after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
2026-05-15 Phase 0: MQTT status publish — state, sensors, temps, timers, error
    Mirrors every operator-relevant value to retained MQTT topics under
    MQTT_TOPIC_ROOT. Topics are change-detected — steady-state traffic is
    just the per-second timer tick, with everything else publishing only
    when the underlying value actually changes.
    Topics this commit adds:
    state STARTUP|DRAINING|RINSING|WASHING|SANITIZE|
    PRESSURE|FINISHED|ERROR
    state/sub INIT|HEATING|IO_CHECK|READY (cleared to "" when
    not in STARTUP, so the dashboard doesn't show a
    stale READY alongside e.g. WASHING)
    keg SMALL|LARGE
    sensors/wat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
    [KegStateMachine.h, KegWasher.ino]
2026-05-15 Phase 0: MQTT command subscribe — start, silence, reset
    Mirrors the physical button surface over MQTT so a Node-RED dashboard
    (or any other subscriber) can drive the cleaner from anywhere on the
    LAN. Subscribed at every (re)connect to kegwasher/cmd/+; callback
    routes the leaf to one of three pending-command flags.
    Topics this commit handles:
    cmd/start Pulses isCycleStartPressed for one tick, picked up by
    whatever state handler reads it next:
    STARTUP_READY → start cycle
    FINISHED → next keg
    ERROR → silence (one-tick pulse falls under
    the 2 s long-press threshold so it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
    [KegWasher.ino]
2026-05-15 Phase 0: heartbeat — uptime, free RAM, loop-max-us at 5 s cadence
    Three retained topics under kegwasher/heartbeat/ that catch the soft-
    wedge case where TCP keepalive (kegwasher/online) lies because the
    PubSubClient.loop() pings are still going out, but the firmware's
    own loop is stuck behind a runaway display call or other blocking
    work.
    Topics:
    heartbeat/uptime_s monotonic seconds-since-boot. Watching
    client treats >10 s gap (= 2x cadence) as
    "wedged." The signal is absence of update,
    not presence — same model as kernel-level
    watchdogs.
    heartbeat/free_ram bytes betwe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
    [KegWasher.ino]
2026-05-29 Diablo16/ViSi-Genie migration: display, MQTT pub/sub, dashboard, tools
    Major in-flight work being committed for preservation; further fixes
    follow in subsequent commits.
    Display migration (Goldelox uLCD-144G2 -> gen4-uLCD-43DT Diablo16):
    - KegDisplay.{h,cpp}: ported from Goldelox_Serial_4DLib to
    genieArduinoDEV. Form/object IDs declared as #defines. Operating-
    state render-once + 1 Hz/5 Hz partial-update pattern.
    - KegStateMachine.cpp: every state handler now drives Genie via
    genie.SetForm / WriteObject / WriteStr.
    - KegWasher.ino: genie.Begin() init, genie.DoEvents() per loop,
    Ethernet + MQTT bring-up integrated.
    MQTT (Phase 0):
    - Status publish: retained, change-detected topics f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
    [KegWasher.cfg]
2026-05-29 KegWasher.4DGenie: revert ComPort regression 1 -> 0
    ComPort 1 puts the Genie host UART on Diablo16's internal COM1 pins,
    but the CC Adapter physically wires Diablo16's COM0 pins to the RJ45
    to the ClearCore. With ComPort=1, the compiled 4XE program tries to
    listen on a UART that's not connected to anything; firmware's
    genie.Begin() handshake silently no-ACKs forever.
    Evidence:
    - .bak (initial state) had ComPort=0
    - Factory SPE2 firmware on the chip uses Diablo16 COM0 by default
    and works fine via Serial Commander over the same physical CC
    Adapter path, confirming COM0 is the wired side
    - Audit (2026-05-29) flagged this as the kill-shot before the
    bank-flash / OBJ_* migration work woul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
2026-05-29 Display: fix OBJ_* indices to ViSi-Genie global per-type numbering
    The OBJ_* defines used Goldelox-style per-form-restart-at-0 numbering,
    but ViSi-Genie indexes objects globally per object-type across the whole
    project. Result: every operating/heating/finished/error screen wrote to
    the wrong widgets (e.g. FORM_OPERATING's water/air/CO2/estop LEDs landed
    on FORM_NOT_READY's widgets; the state-name string hit Form0's splash
    string). FORM_NOT_READY worked only by coincidence (its USER_LEDs are
    0..4 globally).
    Re-derived all indices by enumerating KegWasher.4DGenie in declaration
    order (2026-05-29). Map now:
    - USER_LED 0..15, LED_DIGITS 0..7, STRINGS 0..12 (global per type)
    - Confirmed-by-alias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
    [KegDisplay.cpp, KegDisplay.h]
2026-05-29 Timers: latch keg size for all duration math (fix live-pin bug)
    timers_adjustForKegSize() read the live isLargeKeg pin internally, while
    call sites guarded it with an outer ternary on either isLargeKeg
    (KegWasher.ino MQTT path) or kegSizeLatched (state machine + display).
    Two problems:
    1. The MQTT remaining-time math used the LIVE pin, so brushing the
    keg-size selector mid-cycle made the dashboard's countdown jump
    even though the state machine kept running the latched durations.
    2. When the outer guard was kegSizeLatched but the inner read was
    isLargeKeg, a mid-cycle flip produced an inconsistent result
    (guard says "adjust", inner multiply says x1).
    CLAUDE.md / KegSt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
    [KegDisplay.cpp, KegStateMachine.cpp, KegTimers.cpp, KegTimers.h, KegWasher.ino]
2026-05-31 tools: correct Diablo16 bootloader knock + add reset_test.py
    Forensic analysis of tools/pmmc-successful-flash.strace (the successful
    PMMCLOADER flash) proved the real bootloader knock is uppercase "4DGL"
    at 115200 baud, with the chip replying "db16" — NOT the "4dgl"+"U"@9600
    -> 0x44 'D' that diablo_probe.py and the README previously claimed (the
    strace shows no lowercase token, no standalone 'U'/0x55, no UART BREAK).
    - diablo_probe.py: HANDSHAKE b"4DGL", DEFAULT_BAUD 115200, detect "db16"
    reply (was b"4dglU"/9600/0x44).
    - tools/README.md: corrected protocol note; documented reset_test.py.
    - reset_test.py: DTR/RTS line/polarity/width sweep (no serial writes) to
    find which native Linux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
2026-05-31 tools: add Track-A DTR measurement + Track-B ClearCore reset test
    Two measurement-gated artifacts for the automated-reset plan:
    - tools/dtr_hold.py (Track A / A1): holds CP2104 DTR (or RTS) on long
    dwells so a DMM/scope can measure whether Linux physically toggles the
    DTR pin. Decides the highest-leverage question: if the Linux DTR reset
    is fixable, Workshop4 does the multi-reset Bank 0 itself.
    - tools/cc_reset_knock/cc_reset_knock.ino (Track B / B1): ClearCore sketch
    that resets the display via COM1 RTS (-> SW1 -> RESET), then knocks
    "4DGL" @115200 and checks for "db16", reporting over USB. Mirrors the
    verified KegDisplay.cpp COM1/RTS pattern. Compiles for ClearCore
    (137016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
2026-06-04 Display: raw-serial KegDisplaySerial UI (no ViSi-Genie)
    Drive the gen4-uLCD-43DT (Diablo16) directly with SPE serial graphics
    commands from the ClearCore — no ViSi-Genie, no Workshop4. Uses the
    factory SPE2 @9600 already on the panel, sidestepping the PmmC blocker.
    KegDisplaySerial.{h,cpp}: portrait 272x480 renderer with per-state
    screens (startup/notReady/ready/heating/operating/finished/error),
    flicker-free partial updates (timer/status), footer banner showing IP +
    MQTT pub/sub indicator dots, raw-framed touch reads, and an RTS reset
    pulse in begin() to recover the panel from runtime-error halts.
    Framing notes (hard-won): draw with write-only GetAck commands + RX
    drain; strings via put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
    [KegDisplaySerial.cpp, KegDisplaySerial.h, cc_serial_heartbeat.ino, diablo_baud_probe.ino, diablo_cal.ino, diablo_draw_test.ino, diablo_touch_demo.ino, diablo_touch_test.ino]
2026-06-04 Touch: host-side 3-point affine calibration + repeatable cal routine
    The Diablo touch cal registers (XMINCAL...) and raw ADC (TOUCH_RAW_X) are
    NOT reachable over serial (the serial lib has peekM/pokeM, not peekW/pokeW),
    so calibrate host-side instead.
    KegDisplaySerial: add touchRaw() (uncalibrated sampling), setTouchCalibration()
    and an affine transform applied in touch() -> returns corrected pixel coords.
    tools/diablo_touch_cal: repeatable 3-point routine — tap 3 crosshairs, it
    averages each, solves screen = [A B C; D E F] . [rawx rawy 1] (3x3 Cramer),
    prints KDS::setTouchCalibration(...), applies it, then a tap-to-test verify.
    Panel measured + verified well-aligned on hardware; coeffi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
    [KegDisplaySerial.cpp, KegDisplaySerial.h, diablo_touch_cal.ino]
2026-06-04 Firmware: integrate serial display backend (drop genieArduinoDEV)
    Rewrite KegDisplay.{h,cpp} to drive the panel via KegDisplaySerial (KDS::*)
    instead of ViSi-Genie — the display_*() API is unchanged so KegWasher.ino,
    KegStateMachine.cpp and KegDiagnostics.cpp need no edits. Removes the
    genieArduinoDEV dependency and the genie form/object index map.
    - KegWasher.ino: genie.DoEvents() -> display_doEvents() (touch pump); MQTT
    pub/sub footer indicators wired (P blinks on heartbeat publish, S on a
    received command) via display_setMqttIndicators() at ~4 Hz.
    - KegConfig: load touch-cal affine coeffs from SD (touchCalA..F); display_init()
    applies them via KDS::setTouchCalibration() (baked de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
2026-06-04 tools: symlink KegDisplaySerial copies to the canonical root module
    The per-sketch copies in tools/diablo_{ui_test,touch_demo,touch_cal} are now
    symlinks to the project-root KegDisplaySerial.{h,cpp} so they can't drift.
    arduino-cli follows the symlinks (all three sketches compile clean).
    [KegDisplaySerial.cpp, KegDisplaySerial.h]
2026-06-04 Touch: on-screen START button (READY + FINISHED screens)
    Add KDS::button(); draw a green START button on the READY and FINISHED
    screens. display_doEvents() hit-tests calibrated touches against the button
    rect and arms a start; display_takeTouchStart() drains it in
    mqtt_applyCmdFlags() into isCycleStartPressed — the same one-tick pulse as
    the physical button / MQTT start command, and refused under ESTOP.
    Compiles clean (35% flash); README screen renders with the button.
2026-06-04 Display: bump SPE link 9600 -> 115200 (12x faster redraws)
    Full-screen redraws were ~0.5-1s at 9600 (per-command ACK over slow serial).
    After the boot handshake, bump the link to 115200: send the setbaud command,
    flush it fully at 9600, switch the host with the RTS-safe ConnectorCOM1.Speed(),
    then verify with gfx_Cls; RTS-reset back to 9600 on failure.
    Note (checked all ends): the lib's setbaudWait CANNOT do this on the ClearCore
    — its host-side _virtualPort->begin() is commented out (host never switches),
    and begin() would float RTS=RESET. ConnectorCOM1.Speed() only toggles SERCOM
    enable + the BAUD register (no PortOpen) so RTS is preserved. BAUD_115200 chosen
    because higher indices have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
    [KegDisplaySerial.cpp, diablo_ui_test.ino]
2026-06-04 docs: update CLAUDE.md/README/TODO for the raw-serial display
    The display moved from ViSi-Genie to raw SPE serial (KegDisplaySerial) this
    session, but the living docs still described the old Goldelox/genie setup.
    Updated: Display section, architecture file list + loop ordering, external
    deps (Diablo_Serial_4DLib, not genieArduinoDEV), hardware list, setup steps,
    and the status summary — gen4-uLCD-43DT (Diablo16) portrait 272x480 @115200,
    write-only+drain framing, calibrated touch, on-screen START, footer MQTT dots.
    Marked docs/display-guide.md as legacy.
2026-06-04 feat: 10-stage cycle with chem recovery + operator controls
    Rework the cycle to the full 10 stages with chemical recovery (caustic and sanitizer blown back to their reservoirs, never to drain): DIRTY_DRAIN, DIRTY_RINSE, DIRTY_PURGE, WASHING, CAUSTIC_RETURN, RINSING, RINSE_PURGE, SANITIZE, SANI_RETURN, PRESSURE. The previously loaded-but-unused dirtyRinse/dirtyPurge timers are now used; adds causticRtn/rinsePurge/saniRtn timers.
    Add per-state safety monitoring + bench-gated entry preconditions (water/air/CO2/caustic-temp/enclosure-overtemp), a one-press-per-keg flow with a one-time power-up pre-check, and on-screen + MQTT cycle controls: PAUSE/RESUME (per-stage safe-hold, frozen timer, pause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
    [KegConfig.cpp, KegConfig.h, KegDiagnostics.cpp, KegDisplay.cpp, KegDisplay.h, KegDisplaySerial.cpp, KegDisplaySerial.h, KegStateMachine.cpp]
2026-06-04 docs: PackML/ISA-88 taxonomy re-base + accurate state/IO tables
    Re-base the state-machine lexicon on PackML (ISA-TR88.00.02) machine states +
    ISA-88 recipe phases (Operations/Phases/phase-classes) + PackML modes. Bring
    io-table.md and state-table.md current to the 15-state firmware (was stale
    5-stage): fix pin map (add A12 causticLevelSensor, CCIO-A6 causticHeaterOut),
    correct display description, add interrupt-capability table + per-phase
    valve/monitor tables. Add packml-rearchitecture-plan.md (planned currentState ->
    machineState + recipePhase split).
2026-06-04 feat: re-architect FSM to PackML/ISA-88 two-axis model
    Split the conflated currentState enum into two orthogonal axes (docs/
    state-taxonomy.md, docs/packml-rearchitecture-plan.md):
    - machineState — PackML (ISA-TR88.00.02): IDLE/STARTING/EXECUTE/HELD/
    COMPLETE/STOPPING/STOPPED/CLEARING/ABORTED
    - recipePhase — ISA-88: the 10 wash phases, run *inside* MACH_EXECUTE
    No legacyState() shim: model + core FSM + all consumers migrate together.
    enterState/exitState split into machine-state choreography vs per-phase
    valve choreography (enterPhase/exitPhase) — chem-never-to-drain RETURN
    combos preserved 1:1. Clean Start/Reset split; PackML recovery path B
    (Aborted->Clearing->Stopped->Rese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
    [KegConfig.h, KegDiagnostics.cpp, KegDisplay.cpp, KegStateMachine.cpp, KegStateMachine.h, KegWasher.ino]
2026-06-04 docs: mark two-axis model as implemented (not planned)
    The PackML/ISA-88 split landed (4222034). Update state-taxonomy.md scope note
    and flag state-table.md for a two-axis rewrite so the docs no longer describe
    the firmware as a flat currentState enum.
2026-06-04 fix(estop): fail-safe active-low polarity for NC safety chain on DI8
    DI6-DI8 are negative-true SINKING inputs (internal 3.3V/10k pull-up, INPUT_PULLUP
    is a no-op on ClearCore). The E-stop is a normally-closed loop from GND through
    the drive-OK contacts + E-stop switch into DI8: healthy(closed)=GND=digitalRead
    HIGH=OK; any break (E-stop/drive fault/severed wire)=open=pull-up=digitalRead
    LOW=TRIP. The old code was inverted (==HIGH/RISING) and would read 'tripped' when
    the chain was healthy.
    - isEstopActive = (digitalRead(ESTOP)==LOW); ISR edge RISING->FALLING.
    - Main loop reacts to POLLED isEstopActive (not just the ISR flag), holds outputs
    off while tripped, and aborts -> MACH_ABORTED —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
    [KegHardware.cpp, KegWasher.ino]
2026-06-04 feat(estop): auto-recover to READY on E-stop release (ISO 13850)
    Pulling the E-stop out (NC safety chain healthy again, isEstopActive false) now
    auto-recovers ABORTED->IDLE->READY after a 300ms debounce — no manual long-press,
    no touch button needed. Per ISO 13850 it lands at READY (permits restart) and does
    NOT auto-resume the interrupted cycle; operator presses START to run. Only applies
    when the abort cause was ERR_ESTOP; other faults still require a manual clear.
    canTransitionTo: allow ABORTED->IDLE. io-table: air/co2/estop NC polarity note.
    Bench-verified: press mid-cycle -> ABORTED (alarm); pull out -> auto -> READY;
    START -> EXECUTE.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
2026-06-04 feat(estop): release returns to PAUSE (preserve + resume the cycle)
    When an E-stop interrupts a running/paused cycle, capture the recipe phase at the
    trip; on release (chain healthy, debounced) return to MACH_HELD (PAUSE) with that
    phase restored instead of discarding to READY. Operator RESUMEs to continue (phase
    re-runs from its top) or STOP/DRAINs to bail. ISO 13850 preserved: paused, not
    auto-resumed. If no cycle was running at the trip, release still goes to READY.
    Also adds a temporary debug/enc_adc + debug/cau_adc MQTT publish (raw filtered
    thermistor ADC) for A9/A10 conversion calibration — remove once calibrated.
    Bench-verified: E-stop mid-WASHING -> ABORTED; pull out -> PAUSE@WA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
2026-06-05 fix(ui): no red stacklight on cycle COMPLETE (red = fault/E-stop only)
    IO4 (alarmOut) is the red stacklight / E-stop LED; lighting it on a successful
    COMPLETE is semantically backwards. machineEnter(COMPLETE) no longer asserts the
    alarm — completion is shown on-screen only (blinking COMPLETE banner). Red now
    means fault/E-stop exclusively. No green tier or buzzer is wired; a positive
    completion indicator can be added later.
    [KegStateMachine.cpp]
2026-06-05 feat(temp): real β3950 thermistor conversion for A9/A10 (Ender3 100k)
    Replace the placeholder map(adc->0..100) with a Steinhart/β conversion for the
    Ender 3 Pro 100k NTC (β3950). Wiring per bench: thermistor from +24V into the
    analog pin, no external divider — ClearCore analog input load is the bottom leg;
    effective load ~32.2k solved from one point (ADC 2225 @ 22.2C/72F, 24.56V, 0-10V).
    V=adc/4095*10; R_t=R_LOAD*(VPLUS-V)/V; 1/T=1/T25+ln(R_t/R25)/β
    Disconnected (ADC<30) -> -99 (fails safe cold). Verified: enclosure reads ~22-24C
    at room ambient; caustic -99 (A10 not connected).
    KNOWN LIMITATION (see next): with 100k+24V+0-10V the pin nears the 10V ceiling
    around ~43C, so this front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
    [KegHardware.cpp]
2026-06-05 feat(faults): unified recovery, 3-state IO4 policy, green banners
    Make every fault recoverable from one consistent model (audit found ABORTED from
    a non-E-stop fault was the only unrecoverable-from-panel node):
    - Unified recovery landing: any abort that interrupted a cycle is captured
    (abortResumePhase, all faults not just E-stop); recovery returns to PAUSE (HELD)
    at that phase, else READY. Same landing whether triggered by E-stop release,
    START long-press, or MQTT cmd/reset.
    - Recovery is GATED on the fault condition being gone (faultConditionActive) —
    can't clear a fault whose cause persists (mirrors 'can't reset E-stop while
    engaged'). E-stop auto-acks on release; other fault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
    [KegConfig.cpp, KegConfig.h, KegDisplay.cpp, KegStateMachine.cpp]
2026-06-05 feat(ui): IEC 60204-1 status colour scheme (title bar + banner)
    Apply a consistent indicator-colour policy to both screen elements (title bar =
    chrome(), flashing banner = banner()), per IEC 60204-1:
    GREEN = normal: WASHING/EXECUTE (was blue), READY
    AMBER = abnormal/held: NOT READY (was red), HEATING, PAUSED, DRAINING
    BLUE = mandatory operator action: COMPLETE (swap keg) (was green)
    RED = fault/emergency: ESTOP, ABORTED, faults
    operatingFrame() gains a barColour arg (GREEN running / AMBER held). Added AMBER
    (0xFD20) + BLUE (0x001F) to the KegDisplay palette. Banner colours now match the
    title (NOT READY/HEATING amber, COMPLETE blue, PAUSED amber).
    Still in Pass 2: make the fl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
    [KegDisplay.cpp, KegDisplay.h, KegDisplaySerial.cpp, KegDisplaySerial.h, KegStateMachine.cpp]
2026-06-05 feat(ui): Pass 2 — RECOVER button, action-only banner, READY/NOT_READY merge
    A) Fault recovery UX:
    - Error screen gets a blue RECOVER touch button (drained -> stateMachine_reset(),
    which refuses while the fault condition is still active).
    - Flashing banner is now the ACTION, not the fault name: 'RELEASE E-STOP' /
    'HOLD START 2s' (recoveryHintText); the title/message say what's wrong.
    - COMPLETE banner -> 'SWAP KEG' (blue) instead of duplicating the title.
    B) Readiness screen merge:
    - One KDS::readiness() renders both states: always the 4 signal rows; title +
    colour = READY(green)/NOT READY(amber); START shown only when all-OK. ready()/
    notReady() kept as thi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
    [KegDisplay.cpp, KegDisplay.h, KegDisplaySerial.cpp, KegDisplaySerial.h, KegStateMachine.cpp, KegWasher.ino]
2026-06-06 docs: sync state-table + CLAUDE.md to the two-axis FSM
    Rewrite docs/state-table.md from the stale flat-currentState layout to the
    as-built two-axis model: Axis A machine-state table (MACH_* incl. timeouts +
    transitions), Axis B recipe-phase table (per-phase outputs/monitors/timers),
    IDLE sub-states, HELD overlay, canMachTransition rules, the unified
    abortRecover() recovery path + IO4 3-state policy, and a two-axis flow diagram.
    Honestly flags the as-built gap that MACH_CLEARING is defined + has a handler
    but is currently unreached (abortRecover lands directly at HELD/IDLE).
    Sync CLAUDE.md's architecture line, loop() items 3 & 5, and the State-machine
    section to machineState/recipePhase (wa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
2026-06-06 chore: untrack obsolete Workshop4/ViSi-Genie build artifacts
    The display moved to the raw SPE serial path (KegDisplaySerial) long ago, so the
    genie compiled outputs are dead — 4XE was churning the tree on every Arduino
    build, and the GCI/DAT/TXF resource set is stale. git rm --cached all four
    (kept on disk) and add them to .gitignore; fix the now-false comment that said
    they "get committed".
2026-06-06 feat(config): temp thresholds + MQTT broker → runtime SD config (Phase 3)
    Promote the six temperature thresholds (MIN/OPTIMAL/MAX_CAUSTIC_TEMP,
    MAX_ENCLOSURE_TEMP, FAN_ON/OFF_TEMP) from compile-time #defines to runtime
    globals (minCausticTemp, …) seeded from new DEFAULT_*_TEMP defines and
    overridable from washer.config. Consumers in KegHardware/KegStateMachine now
    read the globals. maxEnclosureTemp being runtime also lets the A9-saturation
    workaround (set ~42) happen without a recompile.
    Promote the MQTT broker config (broker ip/port, user, pass, client_id,
    topic_root) to runtime globals seeded from KegSecrets.h, overridable per device
    from washer.config — a shipped binary can be conf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
    [KegConfig.cpp, KegConfig.h, KegHardware.cpp, KegStateMachine.cpp, KegWasher.ino]
2026-06-06 fix(msg): route the low-caustic-level fault through diagnostics_getErrorMessage
    The last hardcoded display_showError() string in the state machine ("Low
    caustic level") now uses diagnostics_getErrorMessage(ERR_CAUSTIC_LEVEL), so the
    on-screen, detailed, and log wording all agree (Phase 4 message consistency).
    The Phase 4 doc-sync landed earlier in 30e9f5a.
    [KegStateMachine.cpp]
2026-06-06 fix(config): SD config filename must be 8.3 — "washer.config" never loaded
    The classic Arduino SD library (utility/SdFile make83Name) has no long-filename
    support: it rejects any name whose extension exceeds 3 chars. settingsFileName
    was "washer.config" (6-char ext), so SD.open() always failed and the firmware
    silently fell back to compiled defaults ("Config file missing"). The SD config
    has therefore never actually loaded — measured against the lib source, not
    guessed.
    Rename to the 8.3 name "WASHER.CFG"; update README/CLAUDE + rename the example to
    config/washer.cfg.example with a note that the on-card filename must be 8.3/upper.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
    [KegConfig.h]
2026-06-06 fix(indicator): clear IO4 (red) in IDLE/READY — was latched on from boot
    hardware_init() calls allStop(), which drives alarmOut (IO4 red stacklight) HIGH
    as its "everything stopped" convention. At boot stateMachine_init() sets IDLE
    directly (no machineEnter), and nothing in the IDLE path cleared the alarm, so
    IO4 sat lit in READY — contrary to the policy that red = fault/E-stop only.
    Clear the alarm in state_idle() IDLE_INIT (authoritative: IDLE/READY/NOT_READY is
    never a fault) and right after allStop() in hardware_init() (so IO4 isn't lit
    through the boot splash). Neither touches the ESTOP path (ISR + ABORTED still
    light it).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
    [KegHardware.cpp, KegStateMachine.cpp]
2026-06-06 feat(config): realistic per-stage default timers + 5s floor (was flat 3min)
    The flat 3 min/stage default (= 30 min/cycle) was a placeholder and far too long
    — and this is a TWO-HEAD washer, so a cycle already cleans 2 kegs in parallel.
    Replace with realistic per-stage production defaults (≈4.4 min/cycle total),
    WASHING (caustic recirc, 90 s) being the dominant clean; BENCH_MODE still
    compresses to a flat 5 s/stage for fast cardless bench cycles.
    Lower TIMER_MIN_MS 30s → 5s so the genuinely short purge/return/charge stages
    (air blow-down, CO2 charge) are representable. Defaults are 5 s multiples for
    clean ±5 s steps in the upcoming on-screen editor. washer.cfg.example updated.
    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
    [KegConfig.cpp]
2026-06-06 feat(ui): on-screen settings editor (Phase 5)
    Touch editor for the 10 stage timers + largeKegMod, reachable from a SETTINGS
    button on the READY screen. Paginated 4 params/page (3 pages) with per-row
    [-]/[+], PREV/NEXT, and SAVE/CANCEL. Edits live working copies; SAVE commits to
    the globals and writes WASHER.CFG (config_saveToSD), CANCEL discards. Timer step
    ±5 s clamped to [5 s, 30 min]; largeKegMod step ±0.1 clamped to [1.0, 3.0].
    Implemented entirely in the display layer: display_openSettings() sets
    idleSub = IDLE_SETTINGS (state_idle already no-ops there, machineState stays
    IDLE), display_doEvents owns all touch while open, and READY repaints on exit.
    No state-machine changes. Exposed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
2026-06-07 feat(temp): linear 4-20mA caustic temp for ProSense ETS50N on A10
    Replace the (wrong) thermistor beta-curve on getCausticTemp with a linear
    4-20mA -> degC map for the ProSense ETS50N-150-1001 transmitter read across a
    shunt to GND on the 0-10V/12-bit input (range+depth confirmed: 0-10V, 0-4095).
    Using a 470 ohm shunt (4mA=1.88V .. 20mA=9.40V); ETS_SHUNT_OHMS must match the
    installed resistor (set to the measured value for accuracy). Scaled to the
    sensor's native range -50..150C (device default); span in ETS_T_AT_4MA/20MA.
    <3.6mA = open/under-range loop -> fail cold. thermistorTempC now serves only the
    A9 enclosure thermistor.
    Flashed; with the loop open it correctly fails cold (temp/caustic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
    [KegHardware.cpp]
2026-06-07 fix(config): stop config_saveToSD from rewriting the MQTT block
    The on-device Phase-5 settings editor calls config_saveToSD(), which does
    SD.remove + full rewrite. It previously re-emitted the MQTT broker block from
    the live RAM globals, so an operator tuning a timer on the panel could clobber
    the broker creds with stale/placeholder values — and wrote the MQTT password to
    the card on every timer edit. This broke broker auth in the field (MQTT offline,
    frozen uptime) and leaked the password onto the SD card.
    Drop the MQTT block from the rewrite. The device falls back to compiled
    KegSecrets.h creds when the file has no MQTT keys. Trade-off documented inline:
    don't rely on SD-only MQTT creds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
    [KegConfig.cpp]
2026-06-07 feat(bench): boot screen, IO5 green ready lamp, fan→CCIO-A7, IO1 active-high
    Bench-bringup batch from physically re-wiring the panel:
    - Single progressive boot screen (Linux-style). display_init() draws one
    "KEGWASHER" frame; setup() fills status rows as each subsystem comes up
    (SD CONFIG / HARDWARE / NETWORK / MQTT / SENSORS) then display_bootDone().
    cfgLoadedFromSD drives "SD CONFIG: READ OK | DEFAULT" so the operator can
    confirm WASHER.CFG was read. Replaces the old splash chain + the "Using
    default settings" banner.
    - Pin remap: GREEN cycle-start/ready indicator is now its own output on IO5
    (readyLedOut); the enclosure fan moved to CCIO-A7 (cabinFanOut, ON/OFF — a
    CCI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
    [KegConfig.cpp, KegConfig.h, KegDisplay.cpp, KegDisplay.h, KegHardware.cpp, KegHardware.h, KegWasher.ino]
2026-06-08 refactor(hw): remove enclosure temp + fan from the controller
    The enclosure fan is now a standalone self-regulating unit with its own built-in
    thermometer, so the controller no longer senses enclosure temperature or drives a
    fan. This also closes the A9 overtemp gap (the bench thermistor front-end pegged
    ~43 °C and could never sense a real 60 °C overtemp).
    Removed:
    - A9 enclosure thermistor: pin define, analogRead, IIR filter, the NTC
    beta-curve (thermistorTempC), getEnclosureTemp(), enclosureTempValue +
    enclosureTempSensorError. A9 is now free.
    - Fan output on CCIO-A7: cabinFanOut, hardware_setCabinFan, hardware_manageFan
    (hysteresis + safety override), and the diagnostics fan exer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
    [KegConfig.cpp, KegConfig.h, KegDiagnostics.cpp, KegHardware.cpp, KegHardware.h, KegStateMachine.cpp, KegWasher.ino]
2026-06-08 docs(todo): sync roadmap to as-built state (PackML, sensor bring-up)
    The roadmap was dated 2026-06-04 and predated the PackML/ISA-88 merge, the
    Phase 3 config schema, the Phase 5 on-screen editor, and all of the sensor
    bring-up. Updated:
    - New 2026-06-08 status block (PackML re-arch + merge, config schema, settings
    editor, boot screen, IO5 green / IO4 red indicators, IO1 START confirmed,
    A10 ETS50N calibrated, enclosure temp + fan removed, docs synced).
    - Phase 1: caustic-temp item marked done + calibrated; the A9 enclosure-thermistor
    item replaced with its removal (A9 + CCIO-A7 free, code 7 retired). Noted the
    remaining loose end: drop debug/cau_adc now that cal is confirmed.
    - Pha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
2026-06-09 docs(readme): correct stale claims to the as-built state
    The README still described the pre-PackML, 5-stage, Goldelox-era firmware. Fixed
    the inaccurate claims:
    - Cycle Sequence: old 5-stage flow → the real 10-stage recipe with chemical
    recovery, plus the two-axis PackML/ISA-88 framing + operator controls.
    - Configuration: "3 minutes per stage" → per-stage timers totalling ≈4.4 min;
    "Using default settings" banner (removed) → boot screen "SD CONFIG: DEFAULT".
    Noted the on-screen settings editor.
    - Bench mode: "3 min → 5 s, ~25 s / 15 min" → 5 s/stage, ~50 s for 10 stages vs
    ≈4.4 min; corrected state names (IDLE→READY); dropped the false on-screen
    "** BENCH MODE **"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
2026-06-09 chore: remove dead ViSi-Genie/Workshop4 artifacts + stale docs
    The display pivoted to the raw SPE serial path (KegDisplaySerial) on 2026-06-03;
    the ViSi-Genie/Workshop4 project files have been dead weight ever since and the
    firmware never references them.
    - KegWasher.4DGenie (+ .bak) — Workshop4 ViSi-Genie project
    - KegWasher.4DGTX — Workshop4 GTX graphics/touch project
    - KegWasher.cfg — Workshop4 project config (points at KEGW~UCD.*)
    - docs/display-guide.md — documented the old Goldelox 128x128 display (gone);
    fixed the CLAUDE.md + TODO.md refs that pointed at it
    - docs/state-table-original.md — unreferenced pre-rew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
    [KegWasher.cfg]
2026-06-09 chore(tools): prune dead PmmC/Wine-reset/genie-push tooling + doc-inventory
    Cleanup continuation: remove the bench tooling that belonged to abandoned
    efforts — the ViSi-Genie display-push pipeline and the PmmC-bootstrap /
    Wine-reset reverse-engineering saga. The display works via raw SPE serial now,
    firmware flashing is the canonical teknic flash.sh, and ClearCore recovery is
    double-tap RESET / cc_recover.sh.
    Removed tools (17):
    - push.sh — dual-target push helper (display half = genie uSD
    push; firmware half redundant with flash.sh)
    - diablo_flasher.py — PmmC/Driver flasher skeleton (never needed)
    - diablo_probe.py — Dia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
2026-06-10 chore(mqtt): drop temporary debug/cau_adc publish — ETS50N cal confirmed
    Bench-verified post-flash: temp/caustic still publishing, debug topic gone;
    retained copy purged from the broker.
    [KegWasher.ino]
2026-06-10 feat(ui): settings page 2 (pause max, process temps) + INFO page + kegwasher/screen topic
    - Editor grows to 14 params over 4 pages: + pauseMaxMs (1-60 min),
    minCausticTemp / optimalCausticTemp (cross-clamped, capped at the
    SD-only maxCausticTemp safety cutoff).
    - Trailing read-only INFO page: firmware build, IP, broker + conn
    state, config source (SD vs compiled defaults).
    - Display layer tracks a screen id; mqtt_publishStatus mirrors it to
    retained kegwasher/screen so the dashboard replica can follow the
    panel instead of re-deriving screens from state.
    [KegDisplay.cpp, KegDisplay.h, KegWasher.ino]
2026-06-10 feat(nodered): sync dashboard to PackML model, monitor-only, ABORTED alerting
    - State badge reads machineState + IDLE sub-state (IDLE · READY); new
    Phase + Panel-screen rows (kegwasher/phase, kegwasher/screen).
    - Removed: Commands group (monitor+alert only by decision 2026-06-10),
    pre-PackML text-line Screen mirror, Enclosure °C (sensor retired).
    - Alerting: ABORTED >5 min → ALERT row + red toast, with a 60 s
    re-check tick (change-detected publishes never re-fire on their own —
    the old error/message latch could never reach its 5-min condition).
    - Camera stream URL .91 → .96 (bench-vision moved).
    - Deployed to .111 and verified live (headless screenshot: badge showed
    IDLE ·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
2026-06-10 feat(ui): direction-C screen redesign — DejaVu typography, pixel grid, primary/secondary buttons
    Full rewrite of the KegDisplaySerial draw layer to the approved 'minimal
    typographic' design (mockups 2026-06-10):
    - DejaVu Sans / Sans Bold (FONT_7/8) everywhere; glyph widths queried
    once at begin() so labels centre and right-align exactly. Pixel-exact
    placement via gfx_MoveTo (txt_MoveCursor cell grid retired — this was
    the root of the old misalignment).
    - 6 px state edge strip + semantic accents on black; quantized RGB565
    palette from the mockups; thin rules between sections; slim footer.
    - Operating screen: phase title + 'PHASE n/10 - <operator description>',
    large countdown,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
    [KegDisplay.cpp, KegDisplaySerial.cpp, KegDisplaySerial.h, diablo_capability_probe.ino]
2026-06-10 feat(ui+cal): design-C polish round 2 + caustic probe calibration trim
    Display (operator feedback, camera-verified through full cycles):
    - gfx_Cls resets panel text params — transparency now re-asserted in
    cls(); kills the black-box/'underline' behind labels on fills.
    - Vertically-stretched regular text auto-uses the bold face (1x2 looked
    skinny); button labels use balanced NxN scales only, sized up (3x3 /
    4x4) with overstrike extra weight on primary actions.
    - Edge strip is now a whole-cycle countdown bar (sum of phase timers,
    drains top-down; partial updates at 1 Hz).
    - Temps display as F + C; operating temp carries tenths so F is exact.
    - COMPLETE: DONE centred between banner an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
    [KegConfig.cpp, KegConfig.h, KegDisplay.cpp, KegDisplaySerial.cpp, KegDisplaySerial.h, KegHardware.cpp, KegHardware.h, KegWasher.ino]
2026-06-10 feat(ui): polish round 3 — centring calibrated, denser primaries, CAPS, STOPPING countdown, alternating pause lamps
    - Button labels: +4px/scale vertical correction (caps sit high of the
    glyph-cell centre; camera-measured -6px -> -1px). Banner matched.
    - Primary buttons: dense 2-axis overstrike grid — heavier weight, fills
    NN-scaling stairsteps ('8-bit' complaint).
    - All meta/sublabels UPPERCASE incl. phase descriptions ('CONNECT KEGS -
    PRESS START', 'PHASE 4/10 - CAUSTIC RECIRCULATING', 'REMAINING', ...).
    - STOPPING screen gets a 1 Hz 'DRAIN TIME LEFT' countdown — the e-stop ->
    recover -> STOP/DRAIN path previously sat on a static screen that
    looked hung while it was evacuati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
    [KegDisplay.cpp, KegDisplay.h, KegDisplaySerial.cpp, KegHardware.cpp, KegStateMachine.cpp]
2026-06-10 feat(ui): self-measuring font metrics + live READY sensor dots + PURGING wording
    - begin() renders an 'E' and reads it back (gfx_GetPixel, framed) to
    measure where caps actually sit in the FONT_8 cell; button + banner
    labels centre on the measured caps block. Replaces camera-calibrated
    fudge constants per operator request ('do it in code').
    - Primary-button overstrike now scales with text size — genuinely heavy.
    - IDLE_READY redraws when any sensor input changes (was stale: in
    BENCH_MODE allSystemsGo() is forced true, so the READY->NOT_READY
    transition never fires and the dots froze green after DI6/DI7 pulls).
    - STOPPING reads 'PURGING KEG - PLEASE WAIT' / 'TIME LEFT'.
    - Short su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
    [KegDisplaySerial.cpp, KegStateMachine.cpp]
2026-06-10 feat: runtime bench mode (SD-card presence) + LEVEL readiness row + FONT_4 subtitles
    - Bench mode is no longer a compile flag: config_init() sets kwBenchMode
    from SD presence (no WASHER.CFG -> bench: gates bypassed, 5 s stages;
    card -> production). Matches the operator's mental model and removes
    the ship-with-bench-mode footgun. All #ifdef BENCH_MODE sites converted
    to runtime checks; compiled timer defaults are production values.
    - Readiness screens show the caustic LEVEL gate as a 5th row — it is
    checked by allSystemsGo() but had no indicator, producing 'NOT READY
    but everything is green' (bench-reproduced: dry reservoir, all green,
    LEVEL red). READY/NOT_READY change-detect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
    [KegConfig.cpp, KegConfig.h, KegDisplay.cpp, KegDisplaySerial.cpp, KegDisplaySerial.h, KegHardware.cpp, KegStateMachine.cpp, KegWasher.ino]
2026-06-11 fix(io): A12 caustic level is an NC float switch — read digital, not analog
    The level input was read as a 0-10V analog sensor (map to 0-100%) but
    the hardware is an NC float switch S<->G on A-12: closed (level OK) ->
    sunk to GND -> reads HIGH on the sinking input; open (low level or
    broken wire) -> LOW -> fail. Fail-safe by construction, debounced 50 ms
    like the other switches. hardware_getCausticLevel() returns 100/0 so
    the percent-threshold consumers (gates, heater interlock, MQTT topic)
    work unchanged. io-table updated.
    Bench-verified in production mode (card in): level/caustic=100, all
    five readiness gates green, machine reaches READY. Also moved START
    below the 3-row sensor grid (was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
    [KegDisplay.cpp, KegHardware.cpp, KegHardware.h]
2026-06-12 feat: closed-loop PRESSURE on the keg-side switch + COMPLETE swap-keg indicators
    CO2 semantics fix: co2Ok (DI7) is plumbed DOWNSTREAM of the co2Out
    solenoid — it reads keg/line pressure, not supply. The old readiness/
    entry/per-tick gates demanded pressure before the valve ever opened and
    could never pass in production (bench mode was hiding it). Removed all
    three; CO2 supply is unmonitored by design (assumed connected).
    PRESSURE is now closed-loop: the regulator runs well above the keg
    target (it also drives sanitizer blowback), so the phase ends — solenoid
    shut → COMPLETE — the moment the switch trips (2 s settle floor), with
    purgeTimer as the fail timeout → ERR_CO2_PRESSURE 'Ke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
    [KegConfig.h, KegDiagnostics.cpp, KegDisplaySerial.cpp, KegHardware.cpp, KegHardware.h, KegStateMachine.cpp, KegWasher.ino]
2026-06-12 feat(ui): running OUT/IN telemetry grid + drop GET READY ack + touch debounce + level-switch cleanup
    Operating screen now shows the machine's real state while running: an
    OUT section (all 8 actuators — DRN WTR AIR CAU / PMP SAN CO2 HTR, green
    = driven, shadowed in KegHardware via hardware_getOutputBits) and an IN
    row (WTR AIR PRES LVL STP, green = OK/made; PRES grey when open). Per-
    dot change detection keeps the serial link quiet. Bench-verified: DIRTY
    RINSE correctly shows only DRN+WTR driven.
    STOPPED 'GET READY' ack screen removed (operator request): IDLE_READY
    already gates on an explicit START, so the second ack added a tap
    without safety — and its button shared pixels with READY's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
    [KegConfig.h, KegDiagnostics.cpp, KegDisplay.cpp, KegDisplay.h, KegDisplaySerial.cpp, KegDisplaySerial.h, KegHardware.cpp, KegHardware.h]
2026-06-12 feat: full-drain mode on the latching IO2 switch + touch SILENCE + ext heater-permit mode
    Full-drain mode: IO2 is a latching illuminated switch (was treated as a
    momentary DRAIN/ACK button). Latched ON -> DIRTY_DRAIN runs the new
    fullDrainTimer (default 3 min, panel row 'FULL DRN', keg-size scaled,
    WASHER.CFG key) instead of dirtyDrainTimer — for sessions of spoiled/
    undersold kegs that arrive full. Captured at cycle start
    (drainModeLatched, same pattern as keg size); subtitle becomes 'DRAIN
    BAD BEER'; live switch state retained on kegwasher/mode/fulldrain.
    Knock-on rehoming of IO2's old jobs:
    - Park/silence on COMPLETE is now a touch SILENCE button (+ cmd/silence
    routes to the same fla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
2026-06-13 fix(drain): re-read the latching DRAIN switch on RESUME and RESTART
    drainModeLatched was captured only at cycle start (mirroring keg size),
    so flipping the latching DRAIN switch while paused and then resuming/
    restarting kept the old drain duration — the operator's deliberate mode
    flip was ignored until the next fresh cycle. Unlike the keg-size selector
    (global, scales the whole cycle), DRAIN is a single-phase mode toggle, so
    re-reading it on the explicit resume/restart operator actions is safe and
    expected. Also force an operating-screen redraw in both paths so the
    DIRTY_DRAIN subtitle (OLD vs BAD BEER) and the countdown reflect the new
    mode/timer immediately (the loop only redraws the ti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
    [KegStateMachine.cpp]
2026-06-14 fix(heater): harden ext mode for go-live — loud overtemp fault + STARTING timeout
    The ext heater path was compile-tested only. Before it drives a live
    contactor, audited it against failure modes of the external ETS50N
    thermostat and closed two gaps where a failing thermostat went unnoticed:
    1. Overtemp was silent. manageHeaterPermit() dropped the permit at
    maxCausticTemp via overLatch but raised no fault. Reaching the backstop
    means the thermostat failed to regulate at its (lower) setpoint — now
    monitorHeaterExt() (runs every tick, all states, since the tank is kept
    hot continuously) raises ERR_HEATER_OVERTEMP + aborts. The permit's
    overLatch stays as layer-1 physical pro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
    [KegHardware.cpp, KegStateMachine.cpp]
2026-06-14 docs(heater): correct ext-mode E-stop wiring note — power contact, not the NC sense loop
    My earlier note said the permit/coil go 'in series with the E-stop chain'.
    Wrong and unsafe-if-followed: the heater contactor cycles with the
    thermostat, so routing its coil through the DI8 NC sensing loop would read
    every heater off-cycle as an E-stop trip. Corrected across the
    manageHeaterPermit comment, CLAUDE.md, and washer.cfg.example: the permit
    SSR is in series in the heater coil circuit with the ETS50N thermostat;
    E-stop kills heat separately by de-powering the coil-circuit feed via an
    E-stop-relay POWER contact, independent of the NC sense loop. No firmware
    change — the permit's isEstopActiv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
    [KegHardware.cpp]
2026-07-04 release: v1.0.0 — whole-stage drain air, warn-only low temp, full config surface
    Process (operator decisions 2026-07-04):
    - DIRTY_DRAIN: air on for the ENTIRE stage (was a 5 s burst — outputs are a
    property of the state; no mid-phase timed valve changes remain anywhere)
    - Low caustic temp is WARN-ONLY: no WASHING entry gate, no mid-wash abort.
    Steady amber LOW TEMP banner on READY (between START and SETTINGS) and the
    operating screen (banner zone, REMAINING label restored on hide), 2 °C
    re-arm hysteresis. ERR_CAUSTIC_TEMP stays defined, never raised.
    Safety-net fixes:
    - Phase hard timeouts derive from the configured stage timer + 10 min grace
    (fixed 10/20-min tables false-abo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
    [KegConfig.cpp, KegConfig.h, KegDisplay.cpp, KegDisplay.h, KegDisplaySerial.cpp, KegDisplaySerial.h, KegHardware.cpp, KegStateMachine.cpp]
2026-07-04 feat(config): stand-alone network config editor (MQTT cfg mirror + cmd/cfgset + tools/kwcfg)
    Firmware:
    - config_applyKV(): the SD loader's KEY=VALUE chain extracted into a single
    shared rulebook (loader + remote editor), returning applied/unknown/rejected
    - Retained kegwasher/cfg/<key> mirror of the full non-secret config, published
    on connect and after every accepted edit (mqtt* block deliberately excluded)
    - cmd/cfgset (payload KEY=VALUE): validated in loop context, persisted via
    config_saveToSD when a card is present, acked on cfg/ack ("OK ..."/"ERR ...").
    Refused while a cycle is active and for mqtt* keys; temp edits enforce
    floor<=target<cutoff transactionally (violating set i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
2026-07-04 feat(web): operator-grade editor UI + client validation + toggles + benchMode key
    Web editor rework (the incremental look-and-feel pass):
    - Sections organized by the machine state each setting governs (WASH CYCLE ·
    EXECUTE, WARM-UP · STARTING, PAUSE · HELD, WARNINGS & SAFETY, SERVICE &
    CALIBRATION), with friendly operator labels + plain-language hints and the
    raw key name in small monospace underneath
    - Live "= 10 s" / "= 3 min" / "= +1.0 °C" / "= 50% longer" value helpers that
    update as you type; Enter applies; dirty fields highlight amber
    - Client-side validation mirroring the firmware ranges (blocks the send with
    an inline reason + red field; firmware remains authoritative)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
    [KegConfig.cpp, KegWasher.ino]
2026-07-04 feat(net): static IP support (netMode/netIp/netMask/netGw) + editor NETWORK section
    - SD/remote keys: netMode=dhcp|static, netIp, netMask, netGw. Applied at BOOT
    only (a remote edit needs a power cycle). static requires a valid netIp —
    invalid/missing falls back to DHCP with a log line. Unset mask -> /24,
    unset gateway -> .1 on the IP's subnet. Values validated as dotted quads
    on both ends (config_parseIp firmware-side, regex client-side).
    - Editor NETWORK section: dhcp/static toggle (with a check-the-IP-first
    confirmation) + three IP fields; empty means "use the default".
    - No DNS/hostname: the ClearCore lwIP build has LWIP_NETIF_HOSTNAME off and
    no mDNS — documented in wash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
    [KegConfig.cpp, KegConfig.h, KegWasher.ino]
2026-07-05 feat(display): live tank temp on READY/NOT_READY (v1.0.1)
    Sixth readiness cell (row 3, col 1 — the free slot next to LEVEL): whole-°C
    tank temp with a status dot, green at/above the wash floor, amber (text too)
    while the LOW TEMP warning is active. Updated per tick, change-detected in
    KDS so the serial link only carries actual changes; readiness() resets the
    cache so full repaints restore it.
    Context: operator reported the LOW TEMP banner "not going away when temp is
    reached". Bench-verified the banner mechanism is correct (floor lowered below
    the live reading -> warn dropped and the banner erased within a tick, panel
    confirmed by camera) — the firmware's probe reading simply never cro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
    [KegConfig.h, KegDisplay.cpp, KegDisplay.h, KegDisplaySerial.cpp, KegDisplaySerial.h, KegStateMachine.cpp]
2026-07-05 fix(display+mqtt): clean temp-cell redraws + panel saves republish the cfg mirror (v1.0.2)
    - READY temp cell: full-height clear rect (2x glyphs are ~24 px; the 18 px
    rect left the bottoms of previous digits behind — "crumbly" readings).
    - Two-editor desync fix: config_saveToSD() now raises kwCfgMirrorDirty and
    the main loop republishes the retained cfg/* mirror. The PANEL settings
    editor (which has a MIN TEMP row editing minCausticTemp) saves without any
    MQTT path, so a panel edit left the mirror showing a stale floor — operator
    saw "the banner isn't following the config" (live floor 30 vs mirror 84).
    Verified: temp cell renders clean on camera; mirror matches live values
    afte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
    [KegConfig.cpp, KegConfig.h, KegDisplaySerial.cpp, KegWasher.ino]
